darthcloud/BlueRetroHW/README.md

# BlueRetroHW
Kicad for BlueRetro project

BlueRetro

More detail:\
[Main hackaday.io page](https://hackaday.io/project/170365-blueretro)\
[Software files repository](https://github.com/darthcloud/BlueRetro)
