darthcloud/BlueRetroHW/Testjig/testjig.pdf

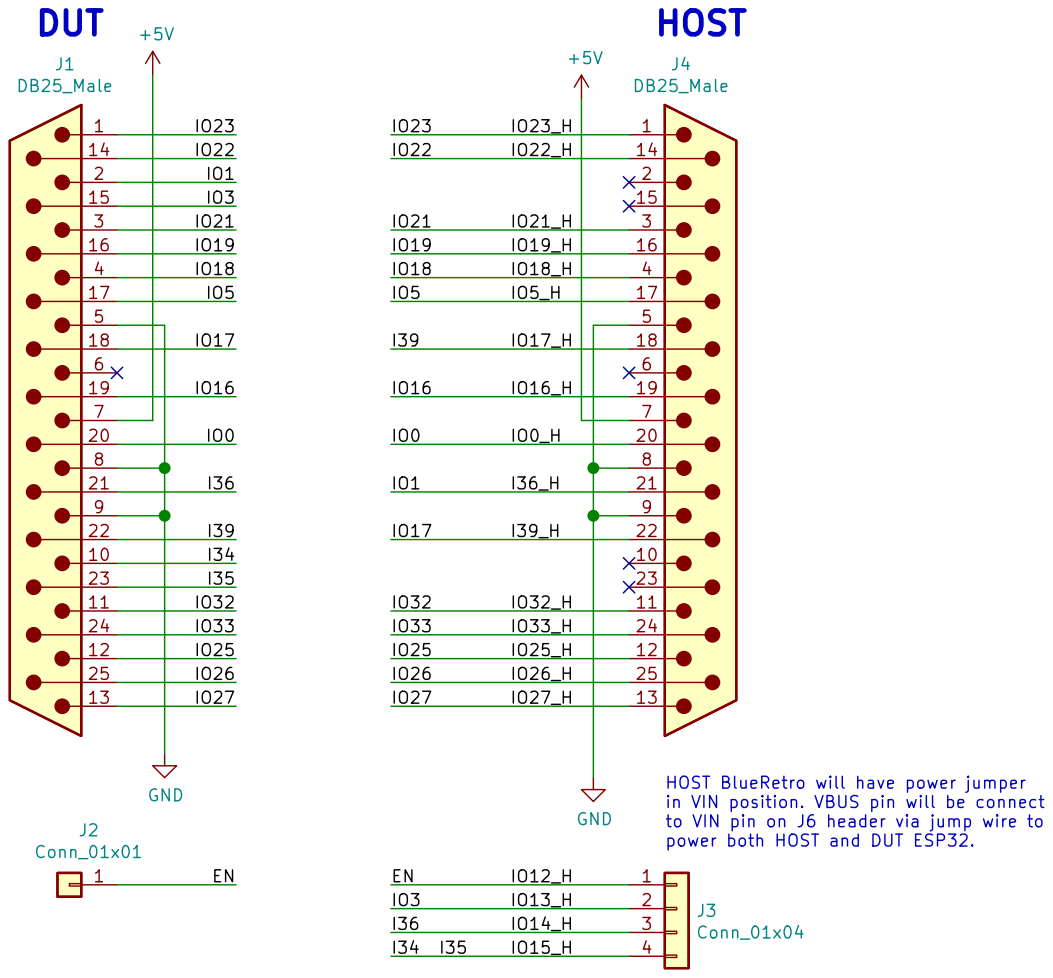
[picture p1: page 1]

HOST BlueRetro will have power jumper
in VIN position. VBUS pin will be connect
to VIN pin on J6 header via jump wire to
power both HOST and DUT ESP32.

File: testjig.sch Sheet: / ©2020 Jacques Gagnon, licensed under CC-BY-4.0

Id: 1/2 Title: BlueRetro Testjig
