darthcloud/BlueRetroHW/Cables/symbol/PinoutReference.pdf

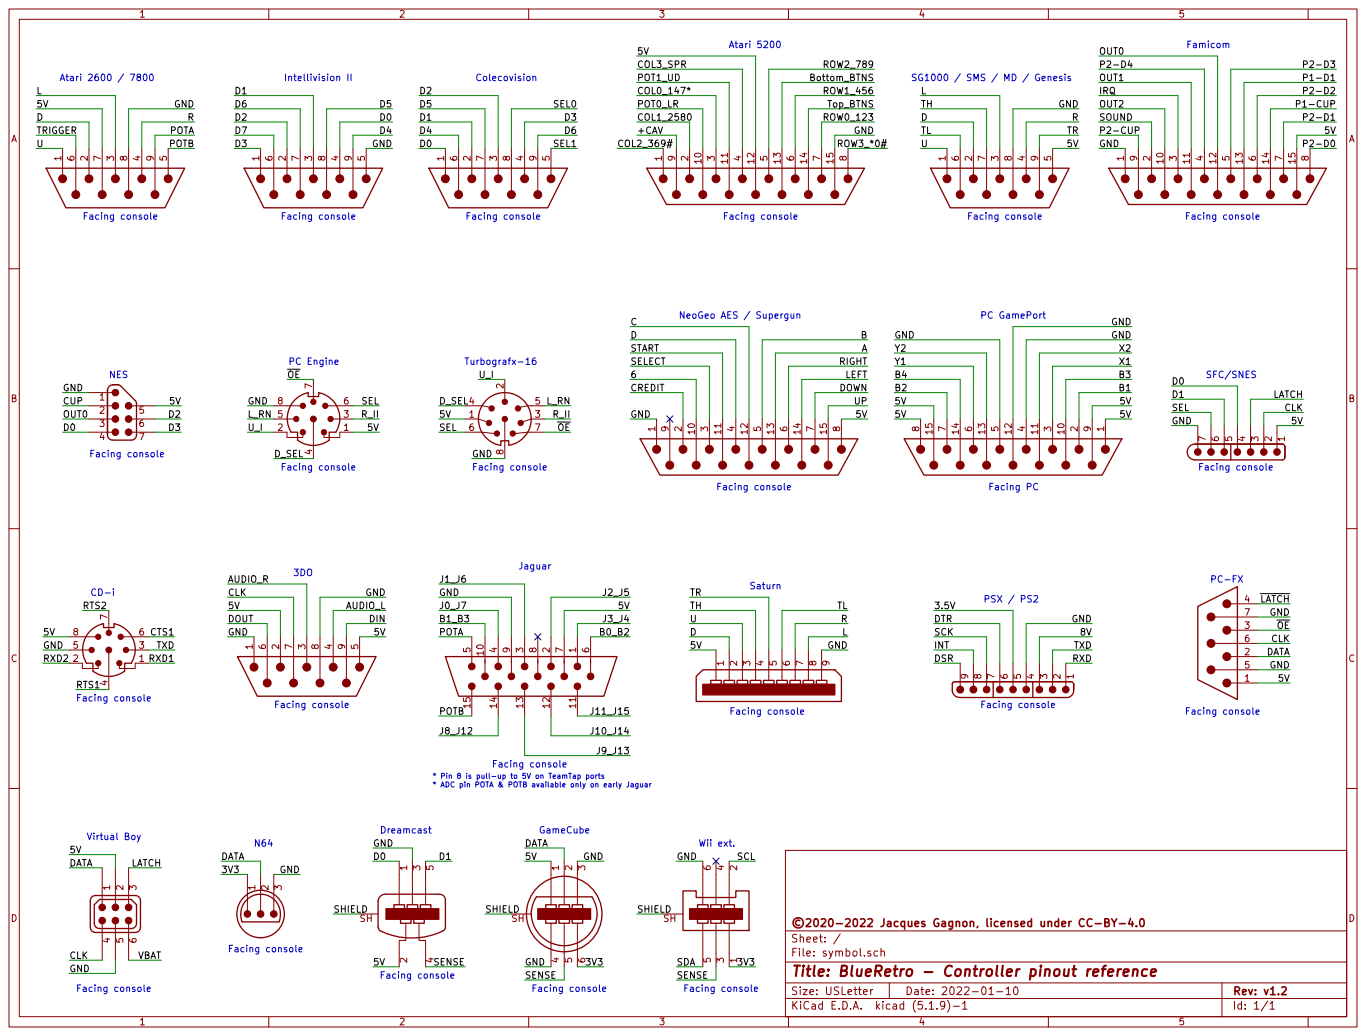
[picture p2: page 1]

LATCHOE DATA CLK GND GND

* Pin 8 is pull-up to 5V on TeamTap ports

File: symbol.sch Sheet: / ©2020-2022 Jacques Gagnon, licensed under CC-BY-4.0

Id: 1/1 Title: BlueRetro - Controller pinout reference
