darthcloud/BlueRetroHW/DIY/AVFC.pdf

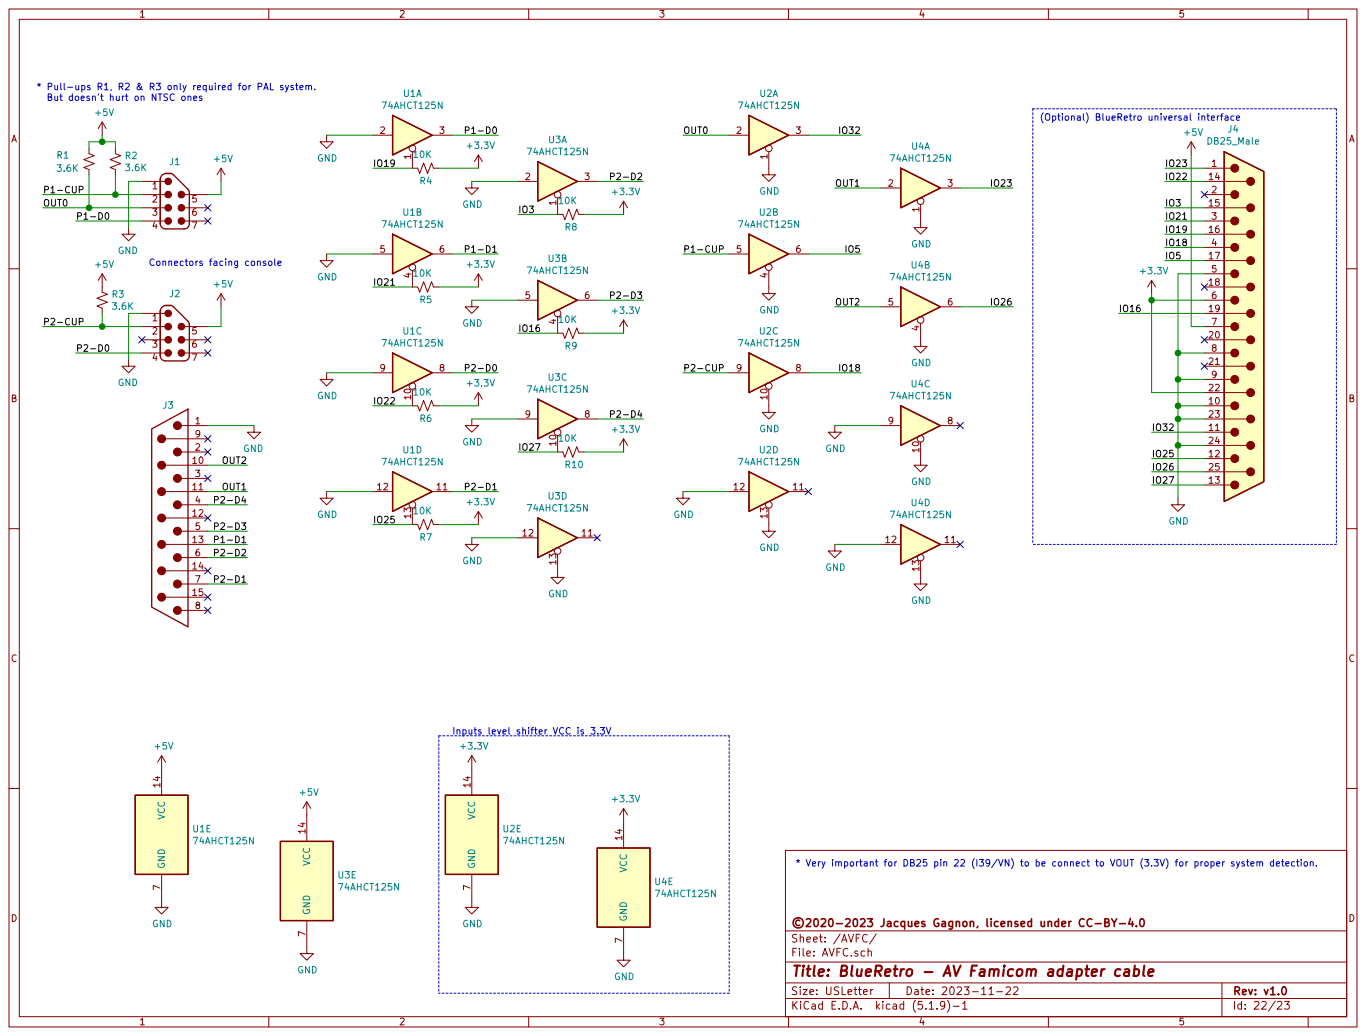
[picture p3: page 1]

* Pull-ups R1, R2 & R3 only required for PAL system.
But doesn't hurt on NTSC ones Connectors facing console

(Optional) BlueRetro universal interface

GND GND GND

Inputs level shifter VCC is 3.3V

File: AVFC.sch Sheet: /AVFC/ ©2020-2023 Jacques Gagnon, licensed under CC-BY-4.0 VCC 14 GND

* Very important for DB25 pin 22 (I39/VN) to be connect to VOUT (3.3V) for proper system detection.

Id: 22/23 Title: BlueRetro - AV Famicom adapter cable
