darthcloud/BlueRetroHW/DIY/FC.pdf

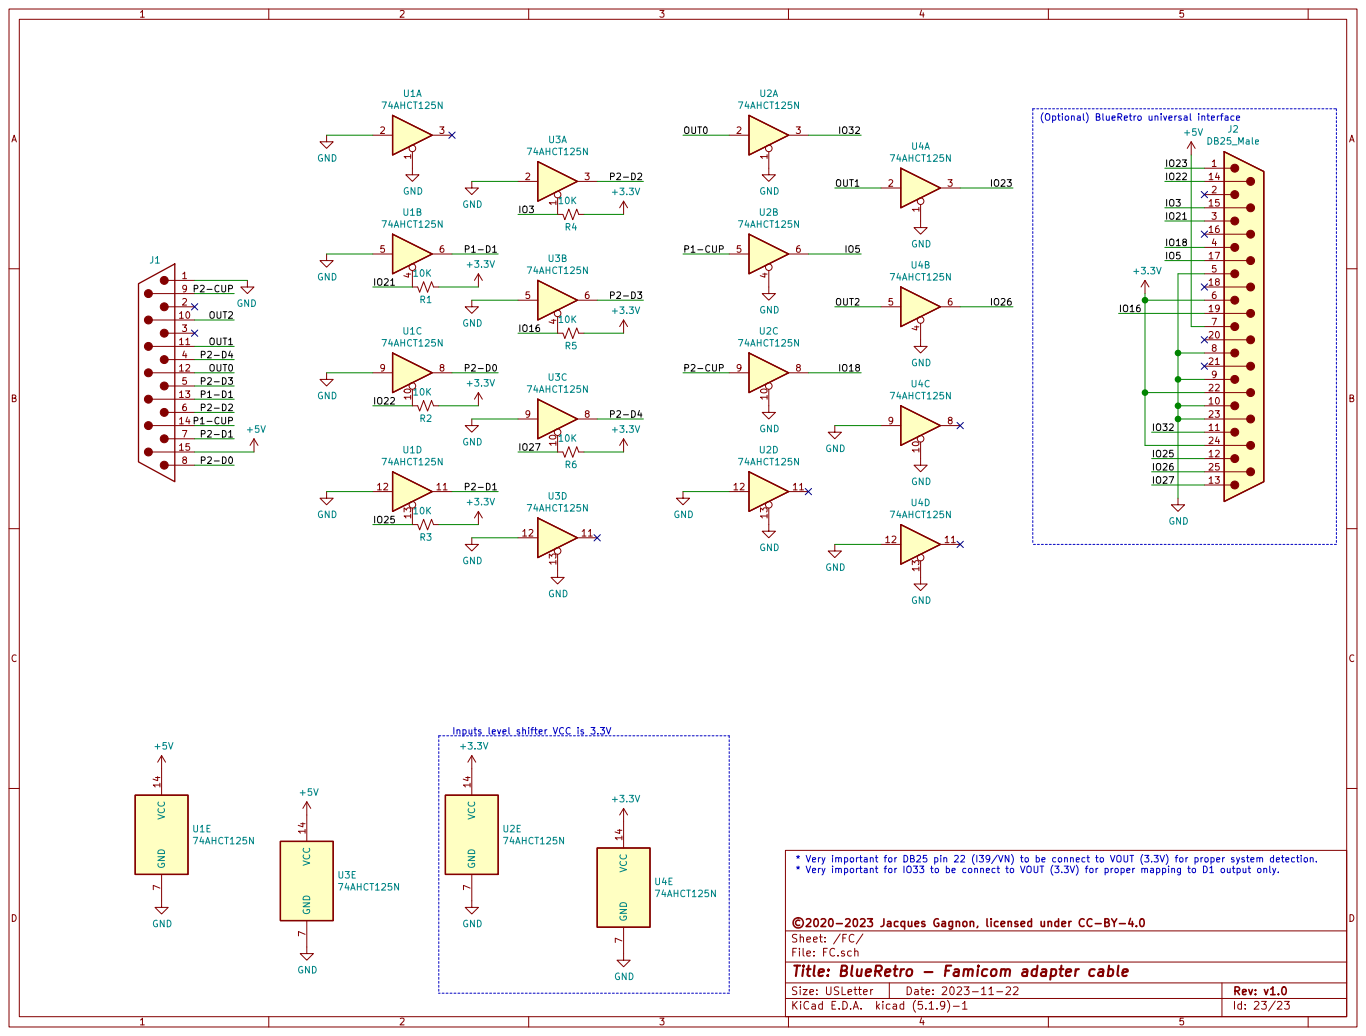
[picture p4: page 1]

GND GND GND GND VCC 14 GND

(Optional) BlueRetro universal interface

74AHCT125N GND GND GND GND

Inputs level shifter VCC is 3.3V

* Very important for DB25 pin 22 (I39/VN) to be connect to VOUT (3.3V) for proper system detection.
* Very important for IO33 to be connect to VOUT (3.3V) for proper mapping to D1 output only.

File: FC.sch Sheet: /FC/ ©2020-2023 Jacques Gagnon, licensed under CC-BY-4.0

Id: 23/23 Title: BlueRetro - Famicom adapter cable
