darthcloud/BlueRetroHW/DIY/NES.pdf

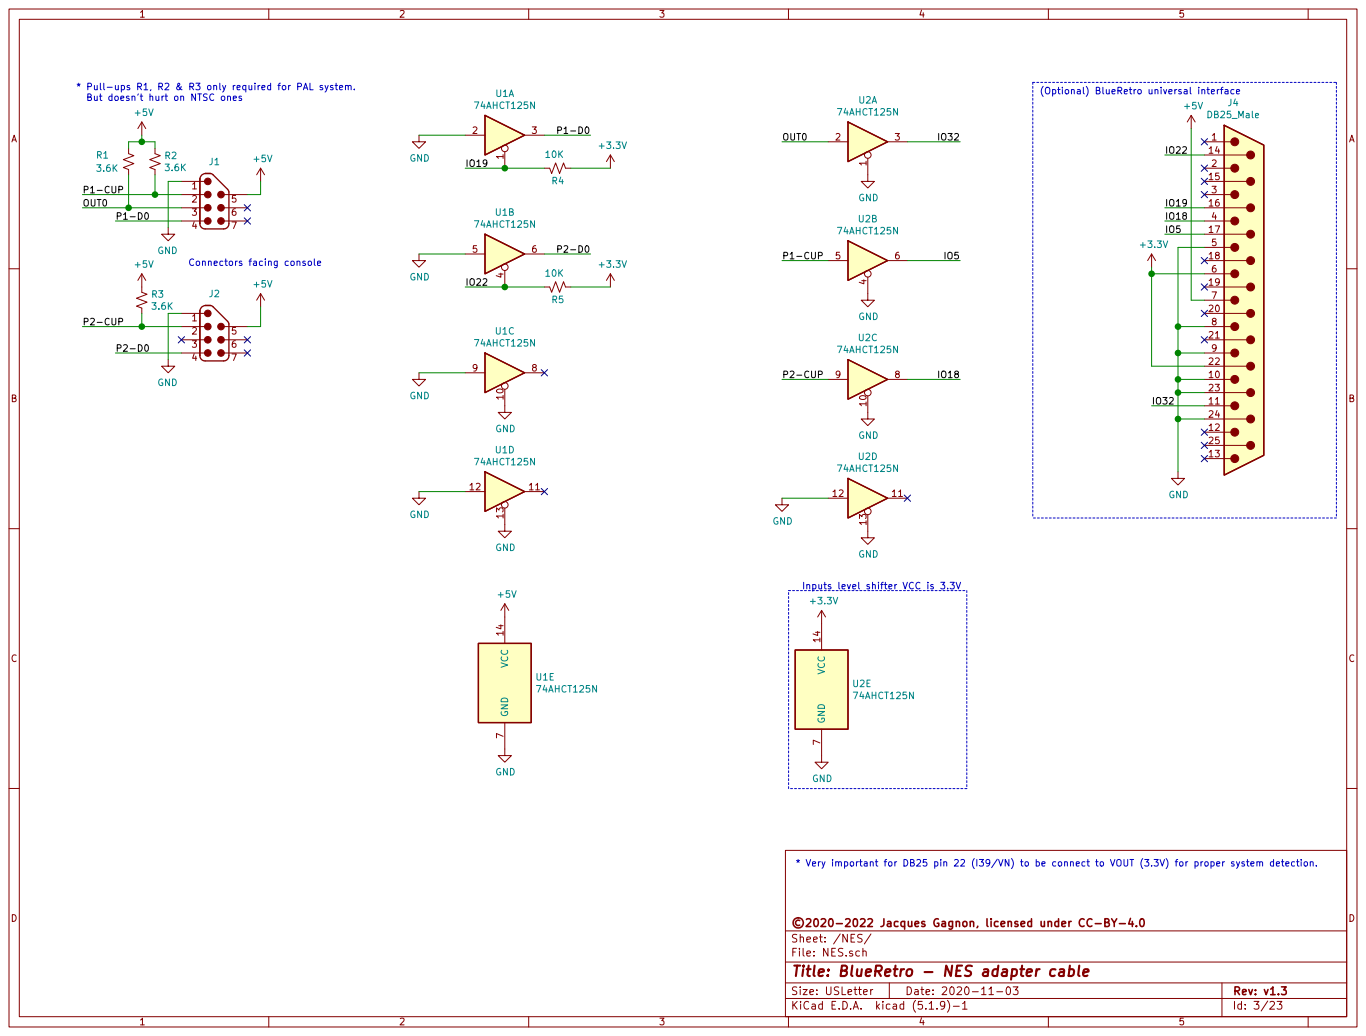
[picture p5: page 1]
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

(Optional) BlueRetro universal interface

Inputs level shifter VCC is 3.3V

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

File: NES.sch Sheet: /NES/ ©2020-2022 Jacques Gagnon, licensed under CC-BY-4.0

Id: 3/23 Title: BlueRetro - NES adapter cable
