darthcloud/BlueRetroHW/DIY/Para1P_OD.pdf

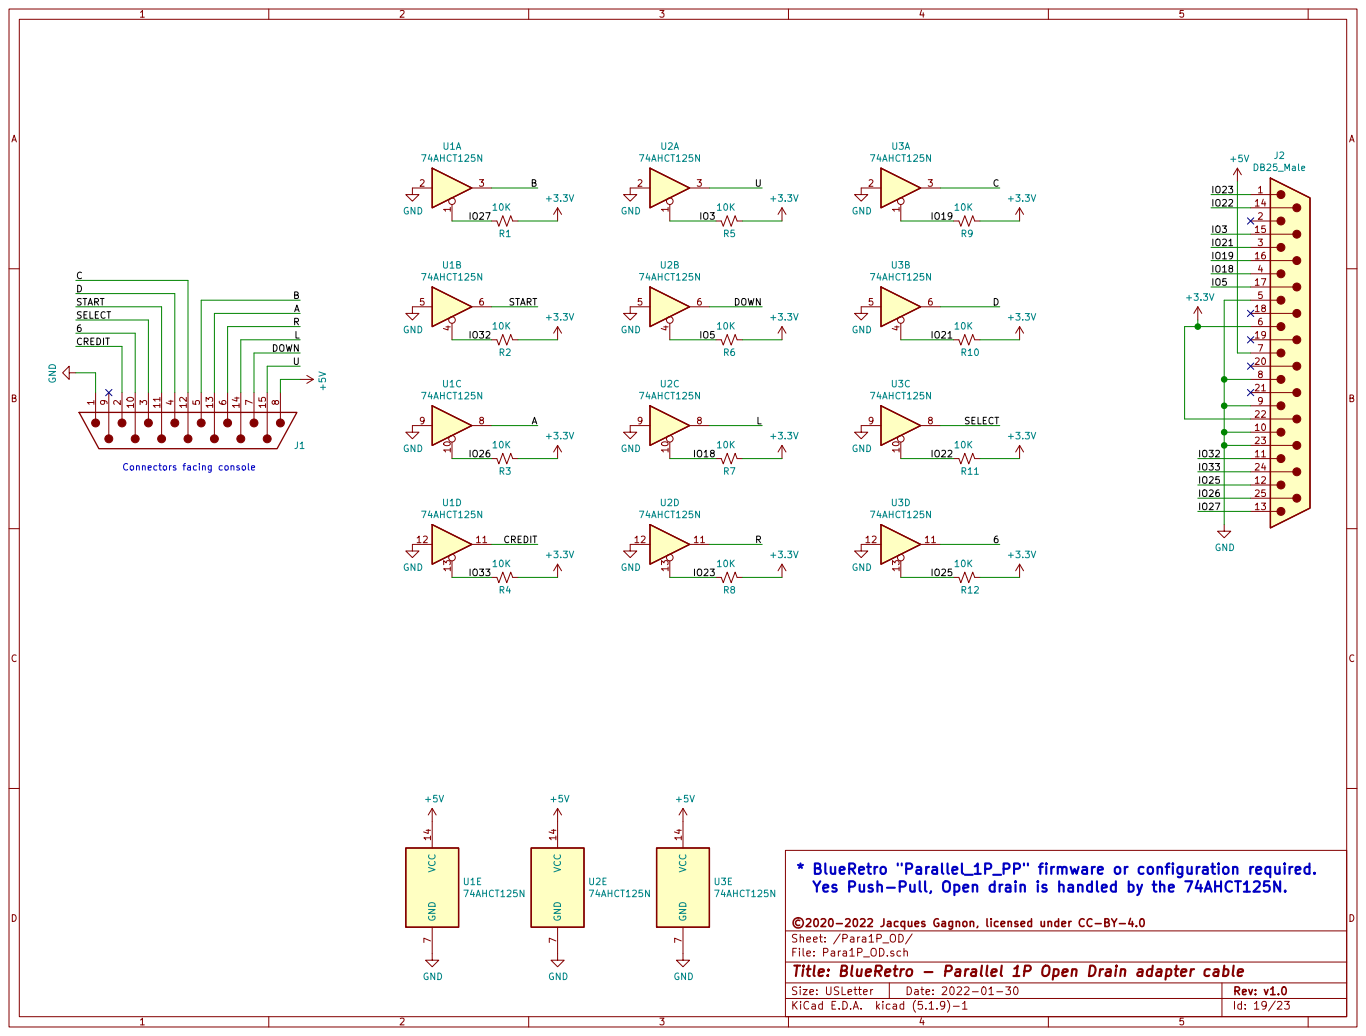
[picture p6: page 1]

* BlueRetro "Parallel_1P_PP" firmware or configuration required.
Yes Push-Pull, Open drain is handled by the 74AHCT125N.

©2020-2022 Jacques Gagnon, licensed under CC-BY-4.0 GND

Sheet: /Para1P_OD/
File: Para1P_OD.sch
Id: 19/23 Title: BlueRetro - Parallel 1P Open Drain adapter cable
