darthcloud/BlueRetroHW/DIY/Para2P_OD.pdf

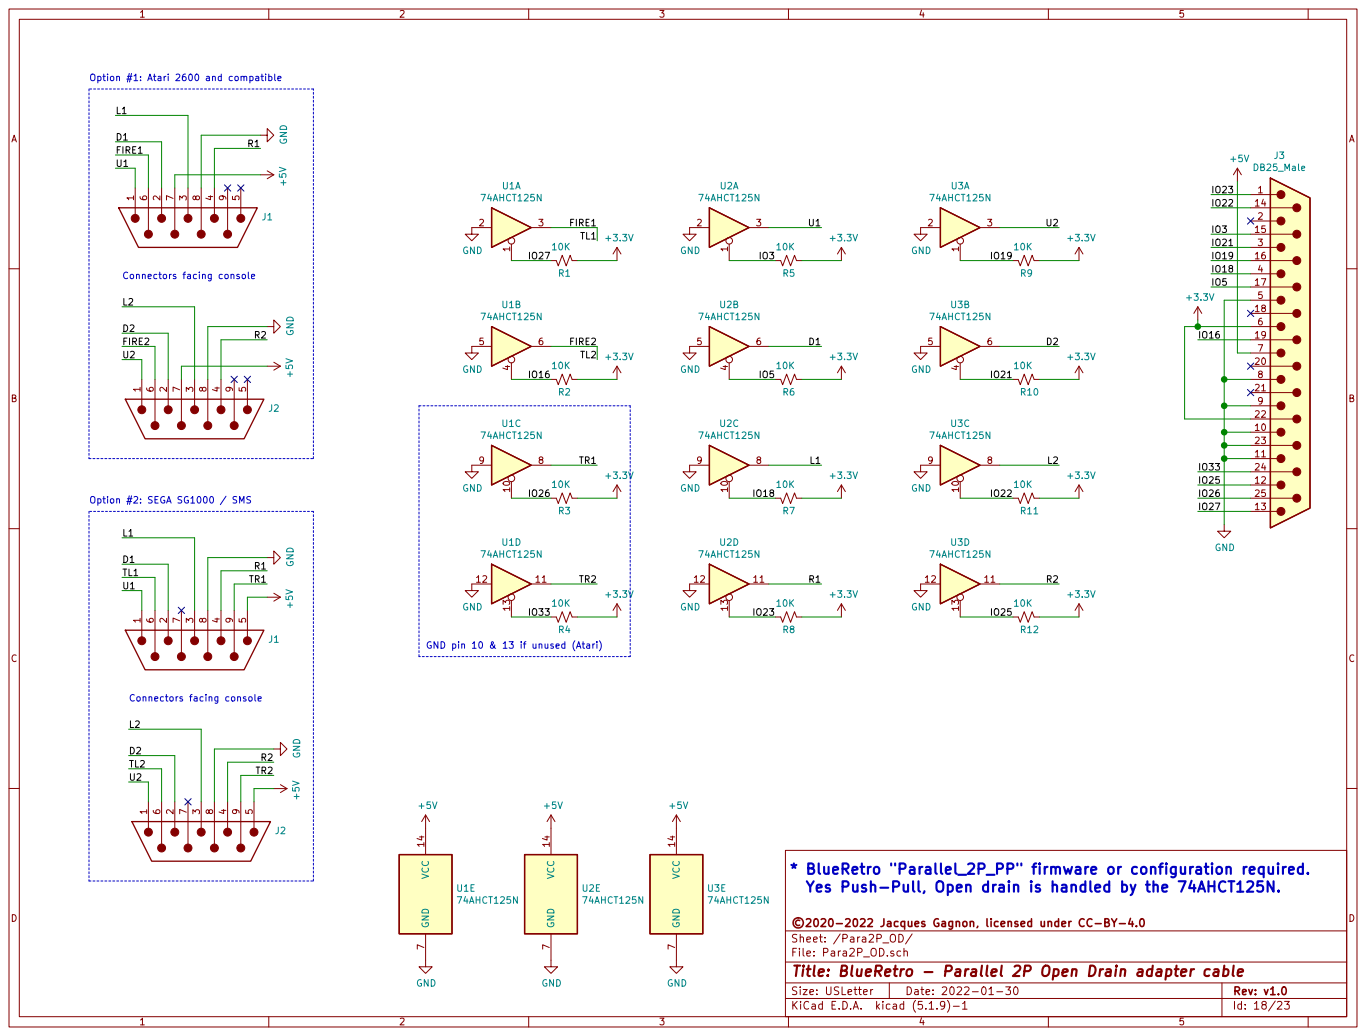
[picture p7: page 1]

Option #1: Atari 2600 and compatible

74AHCT125N GND GND GND GND

GND pin 10 & 13 if unused (Atari)

* BlueRetro "Parallel_2P_PP" firmware or configuration required.
Yes Push-Pull, Open drain is handled by the 74AHCT125N.

©2020-2022 Jacques Gagnon, licensed under CC-BY-4.0
Sheet: /Para2P_OD/
File: Para2P_OD.sch
Id: 18/23 Title: BlueRetro - Parallel 2P Open Drain adapter cable
