darthcloud/BlueRetroHW/DIY/PS.pdf

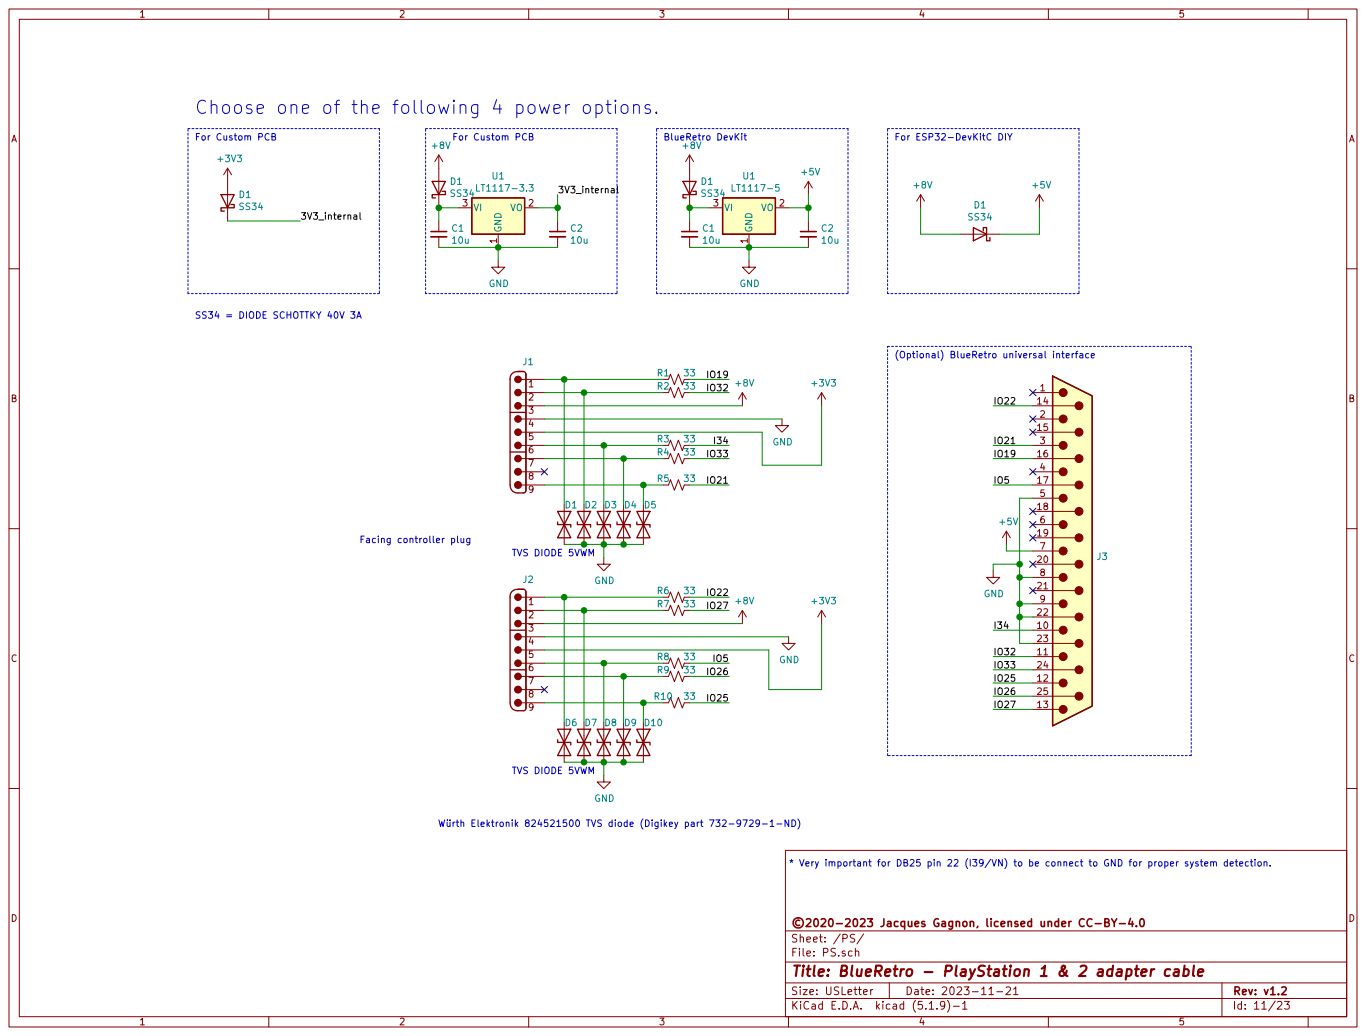
[picture p8: page 1]

IO26 TVS DIODE 5VWM Choose one of the following 4 power options. SS34 = DIODE SCHOTTKY 40V 3A

TVS DIODE 5VWM Facing controller plug

Würth Elektronik 824521500 TVS diode (Digikey part 732-9729-1-ND)

* Very important for DB25 pin 22 (I39/VN) to be connect to GND for proper system detection.

File: PS.sch Sheet: /PS/ ©2020-2023 Jacques Gagnon, licensed under CC-BY-4.0

Id: 11/23 Title: BlueRetro - PlayStation 1 & 2 adapter cable
