darthcloud/BlueRetroHW/DIY/Wii.pdf

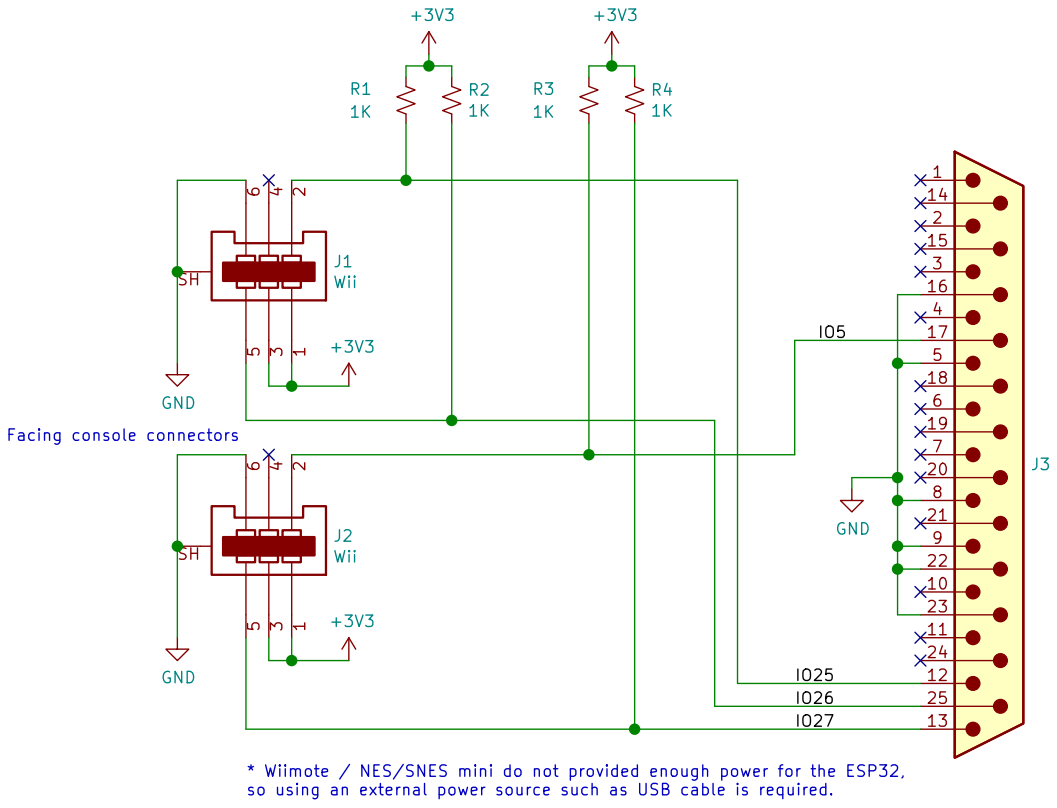
[picture p9: page 1]

* Wiimote / NES/SNES mini do not provided enough power for the ESP32,
so using an external power source such as USB cable is required.

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

File: Wii.sch Sheet: /Wii/ ©2020-2022 Jacques Gagnon, licensed under CC-BY-4.0

Id: 21/21 Title: BlueRetro - Wii extension adapter cable
