darthcloud/BlueRetroHW/DIY/N64.pdf

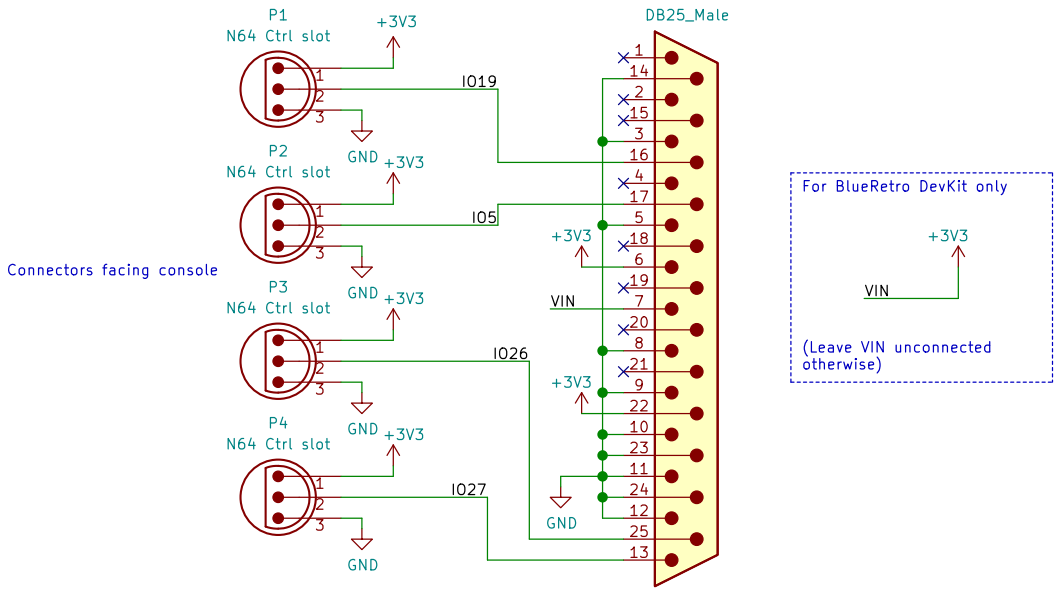
[picture p10: page 1]

For BlueRetro DevKit only

* Very important for DB25 pin 22 (I39/VN) to be connect to VIN (3.3V) for proper system detection.

File: N64.sch Sheet: /N64/ ©2020-2022 Jacques Gagnon, licensed under CC-BY-4.0

Id: 5/20 Title: BlueRetro - N64 adapter cable
