darthcloud/BlueRetroHW/DIY/VB.pdf

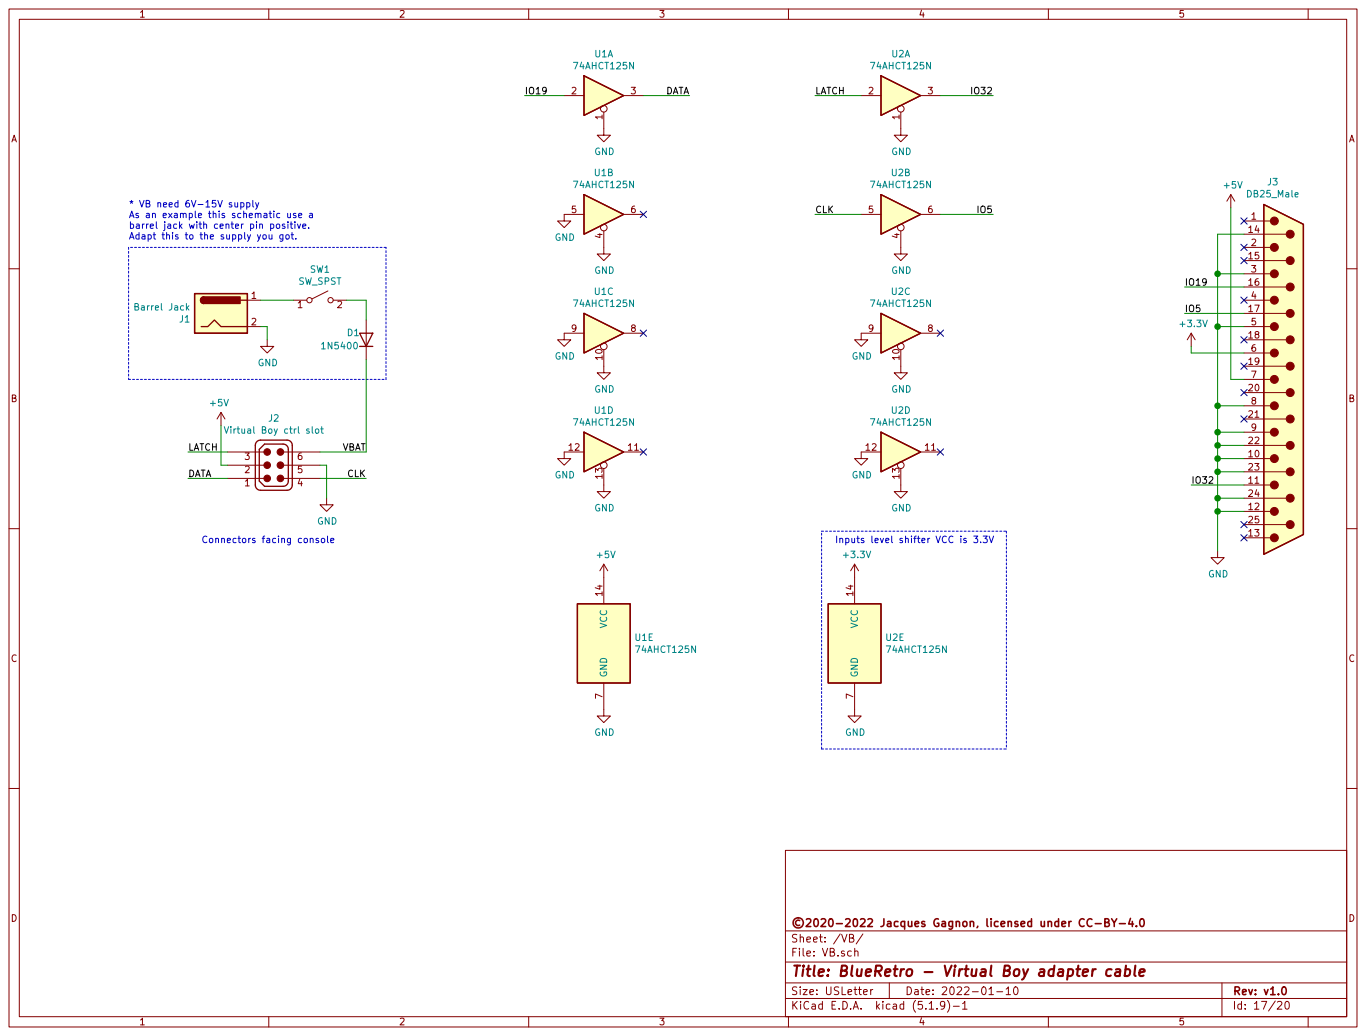
[picture p11: page 1]

* VB need 6V-15V supply
As an example this schematic use a
barrel jack with center pin positive.
Adapt this to the supply you got.

File: VB.sch Sheet: /VB/ ©2020-2022 Jacques Gagnon, licensed under CC-BY-4.0

Id: 17/20 Title: BlueRetro - Virtual Boy adapter cable
