darthcloud/BlueRetroHW/DIY/Saturn.pdf

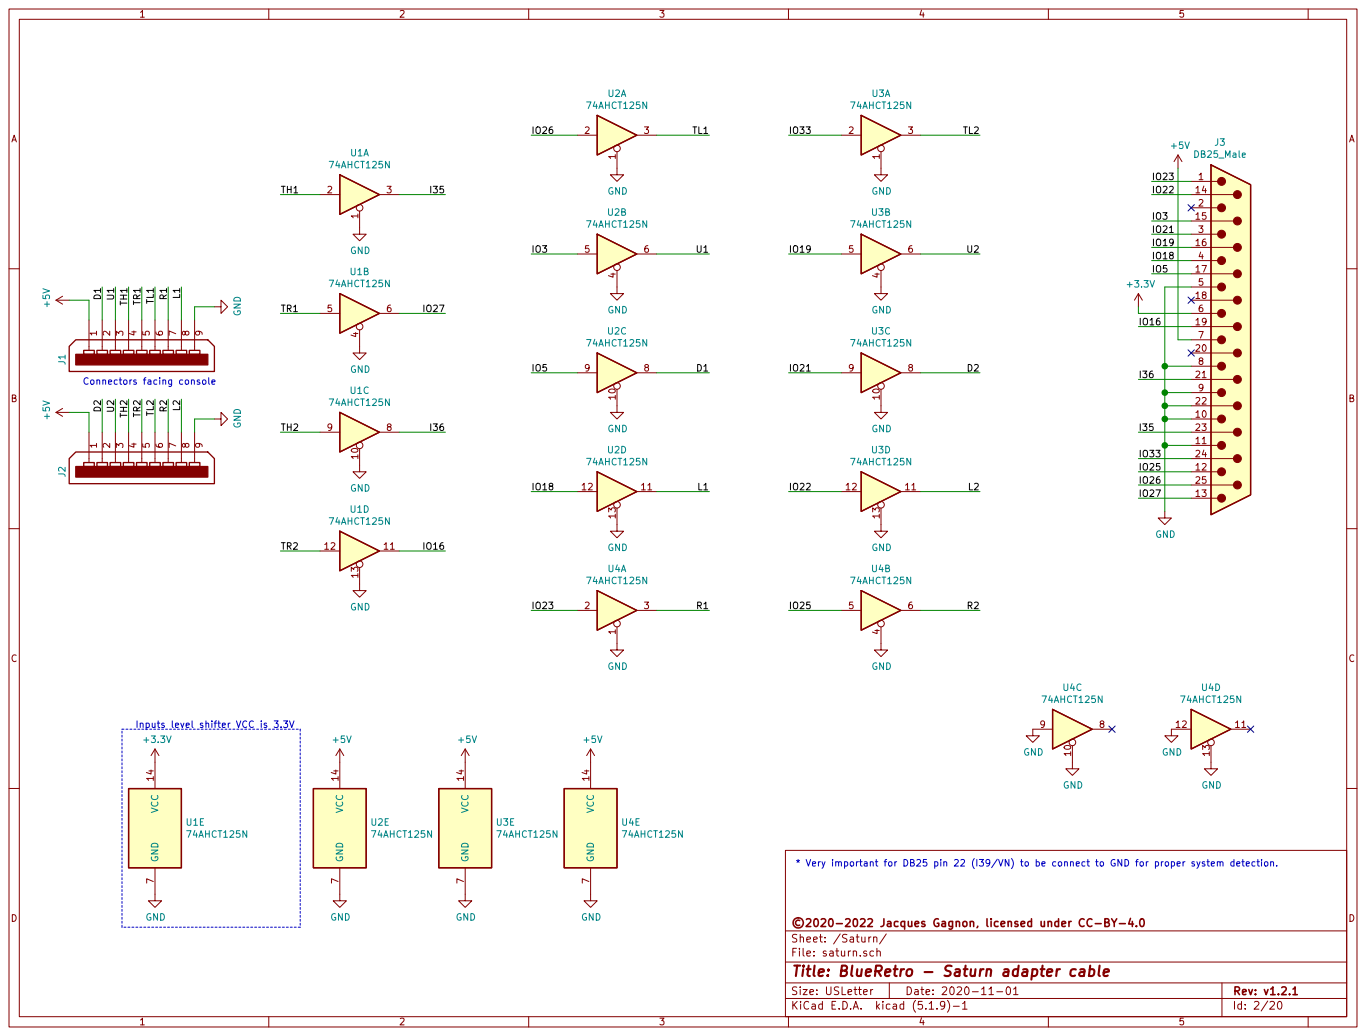
[picture p12: page 1]

Inputs level shifter VCC is 3.3V

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

File: saturn.sch Sheet: /Saturn/ ©2020-2022 Jacques Gagnon, licensed under CC-BY-4.0

Id: 2/20 Title: BlueRetro - Saturn adapter cable
