darthcloud/BlueRetroHW/DIY/PCE.pdf

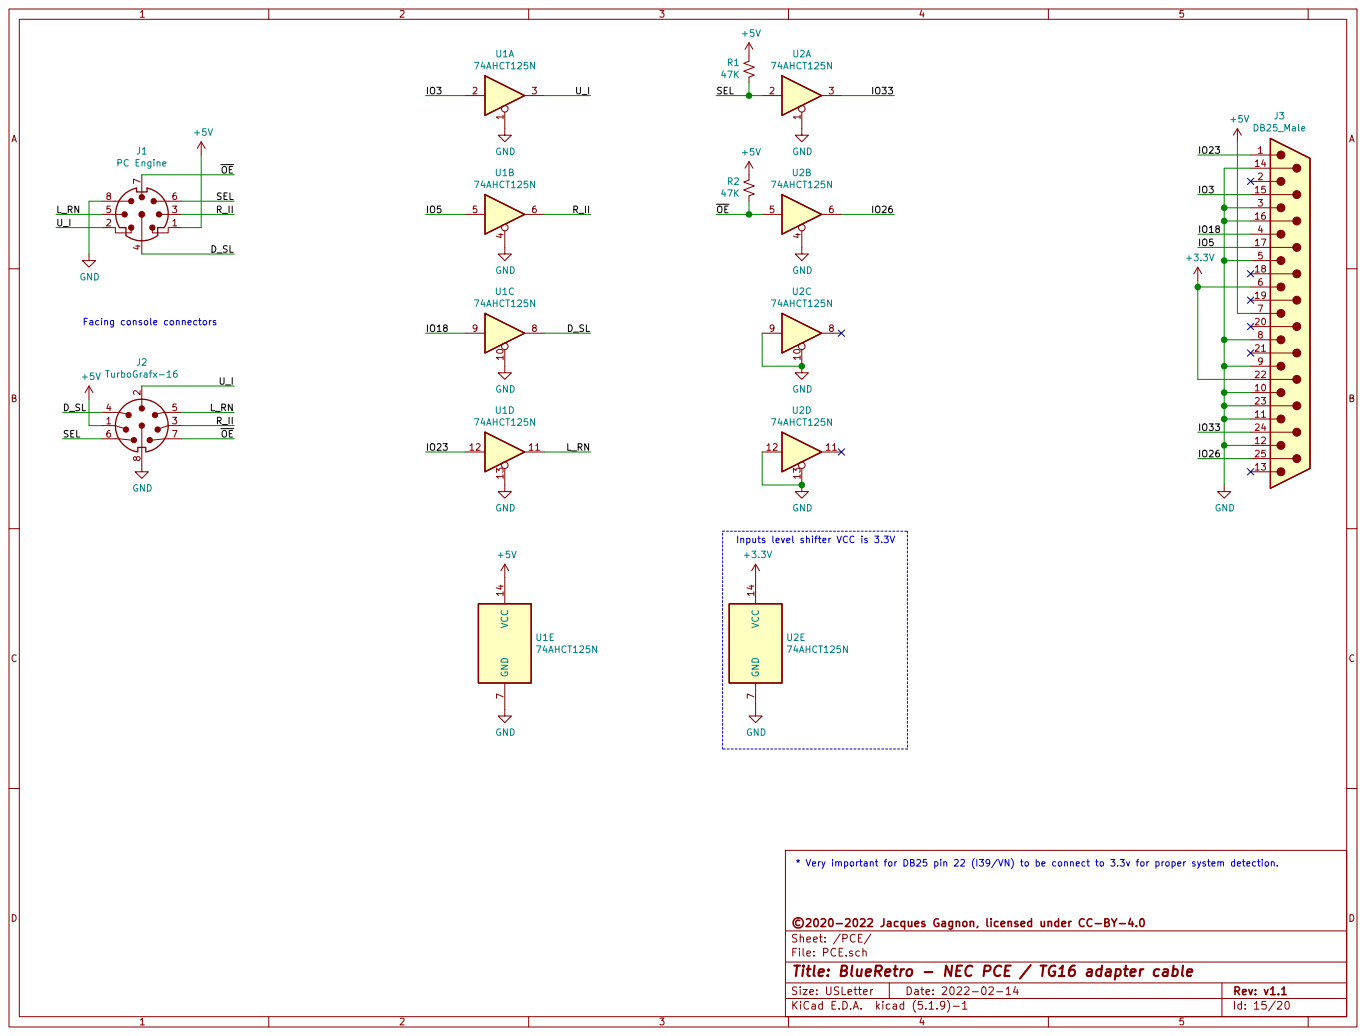
[picture p13: page 1]

Inputs level shifter VCC is 3.3V

* Very important for DB25 pin 22 (I39/VN) to be connect to 3.3v for proper system detection.

File: PCE.sch Sheet: /PCE/ ©2020-2022 Jacques Gagnon, licensed under CC-BY-4.0

Id: 15/20 Title: BlueRetro - NEC PCE / TG16 adapter cable
