darthcloud/BlueRetroHW/DIY/7800.pdf

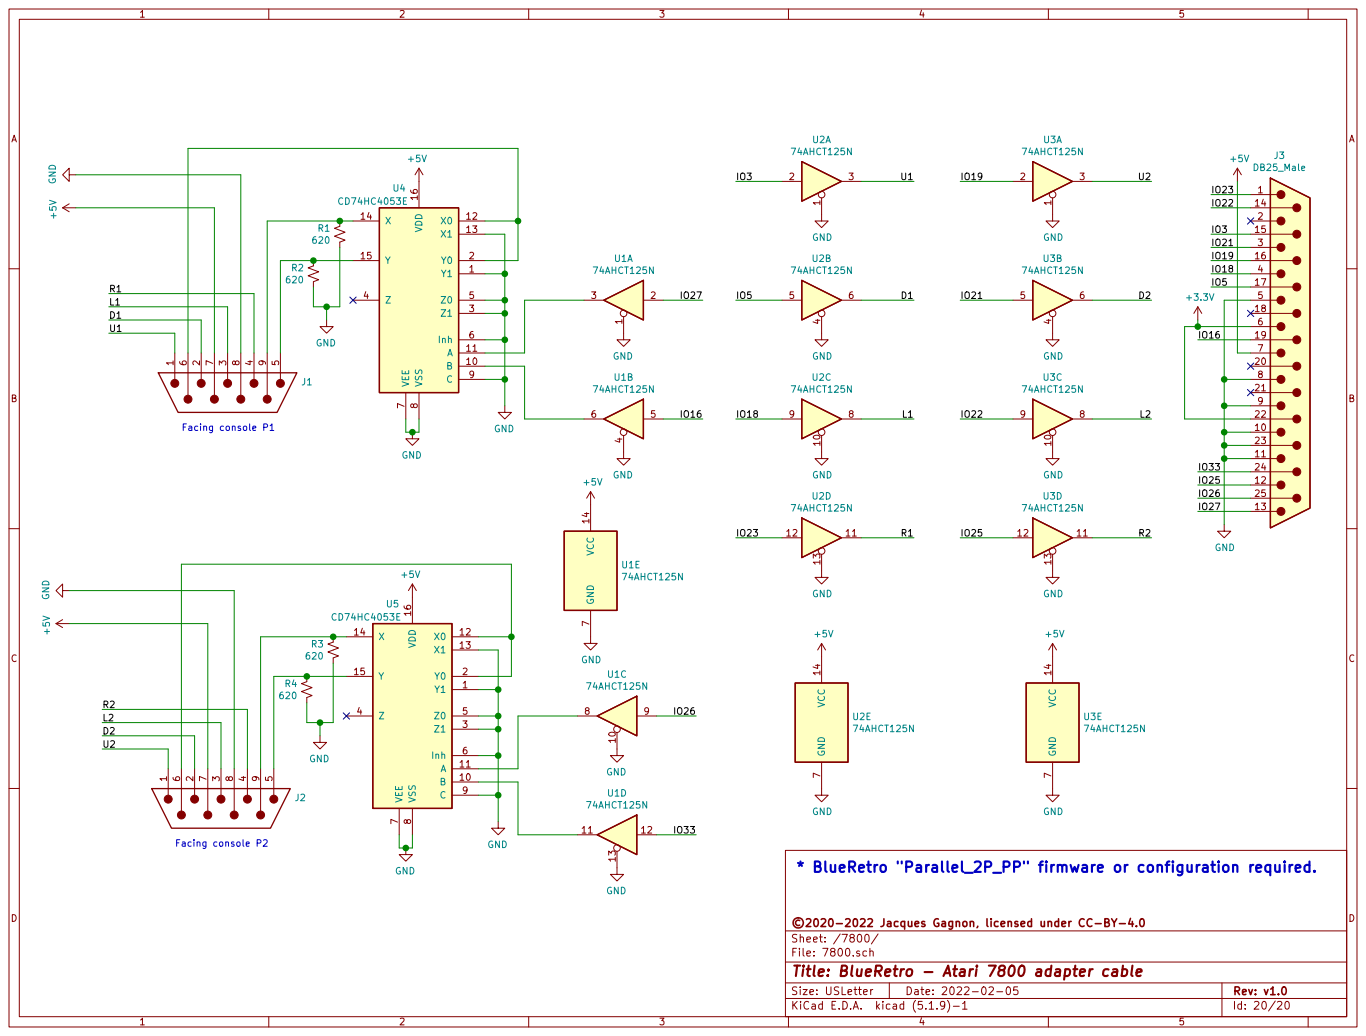
[picture p14: page 1]

File: 7800.sch Sheet: /7800/ ©2020-2022 Jacques Gagnon, licensed under CC-BY-4.0 GND

* BlueRetro "Parallel_2P_PP" firmware or configuration required.

Id: 20/20 Title: BlueRetro - Atari 7800 adapter cable
