darthcloud/BlueRetroHW/DIY/Para1P_PP.pdf

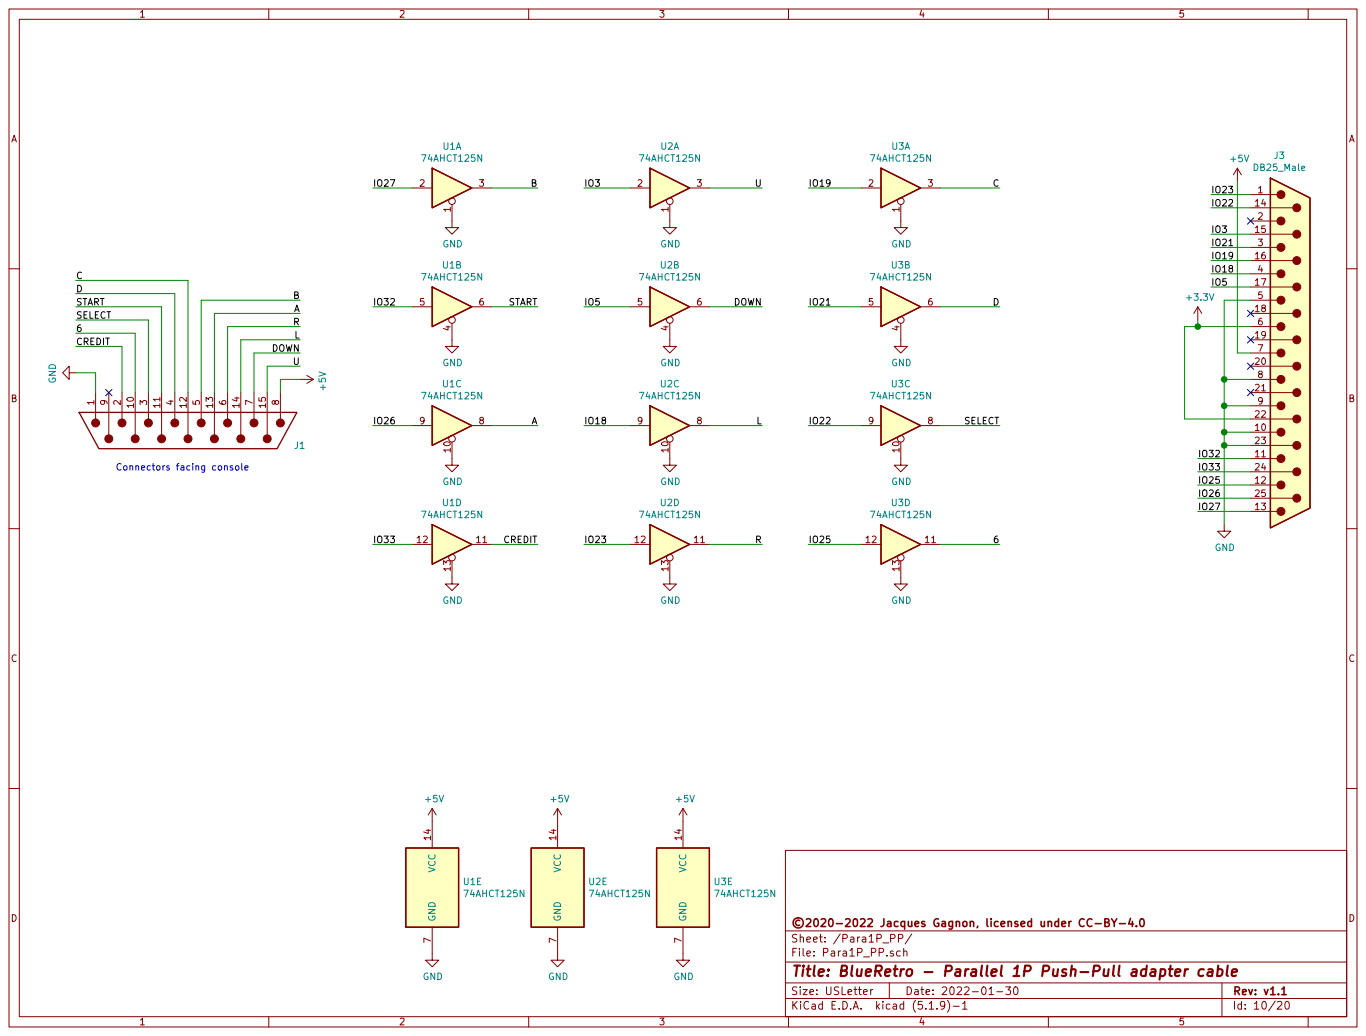
[picture p15: page 1]

74AHCT125N
+5V GND GND GND GND

©2020-2022 Jacques Gagnon, licensed under CC-BY-4.0
Sheet: /Para1P_PP/
File: Para1P_PP.sch
Id: 10/20 Title: BlueRetro - Parallel 1P Push-Pull adapter cable
