darthcloud/BlueRetroHW/DIY/Para2P_PP.pdf

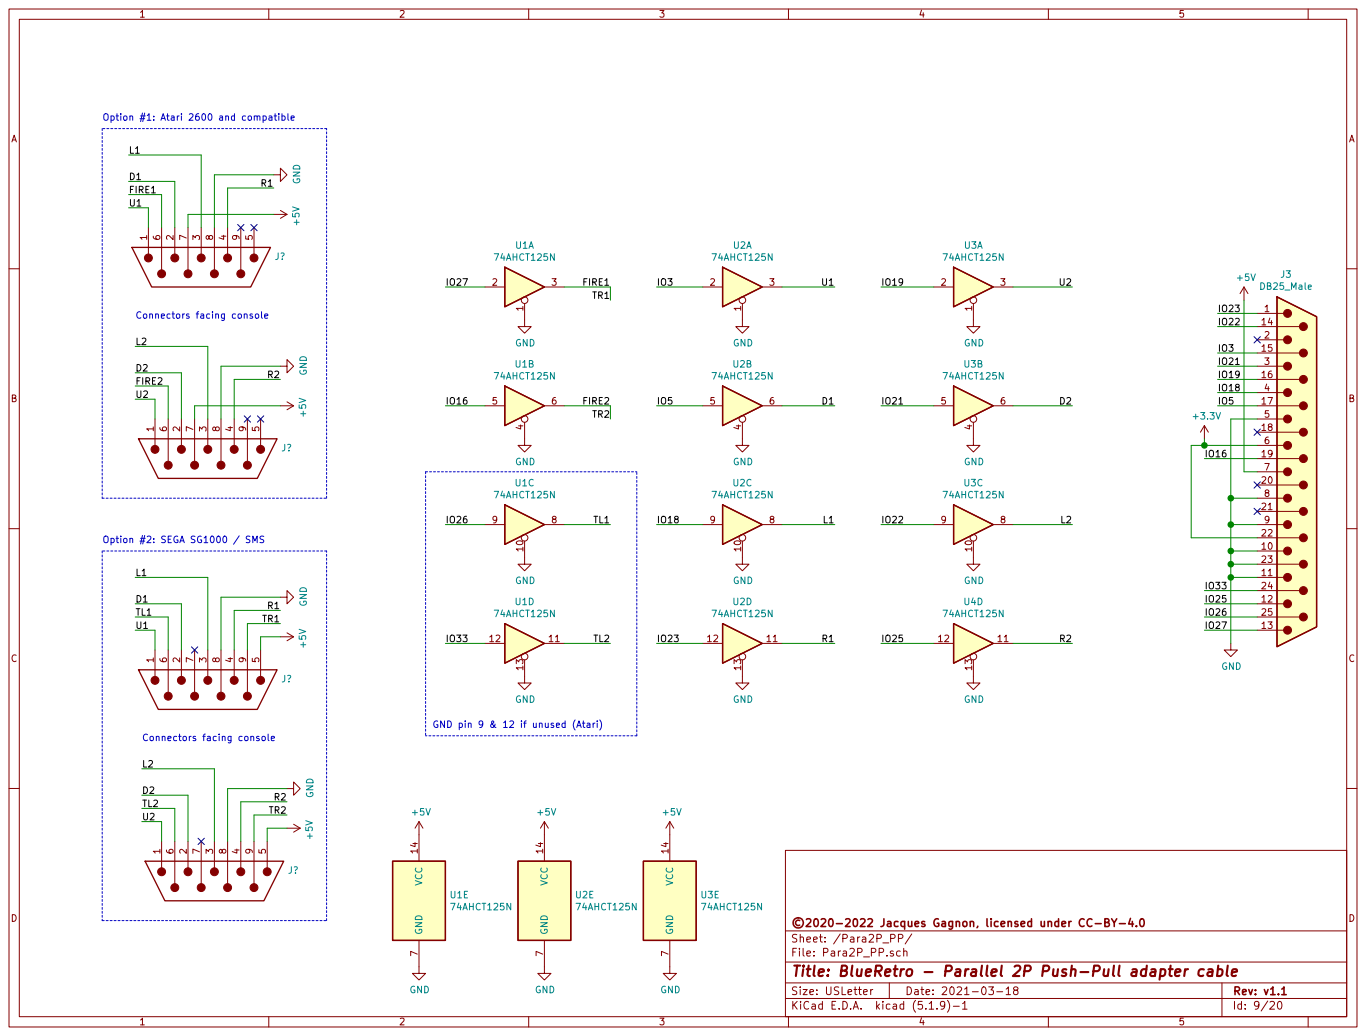
[picture p16: page 1]

Option #1: Atari 2600 and compatible

Sheet: /Para2P_PP/
File: Para2P_PP.sch
Id: 9/20 Title: BlueRetro - Parallel 2P Push-Pull adapter cable
