darthcloud/BlueRetroHW/DIY/JAG.pdf

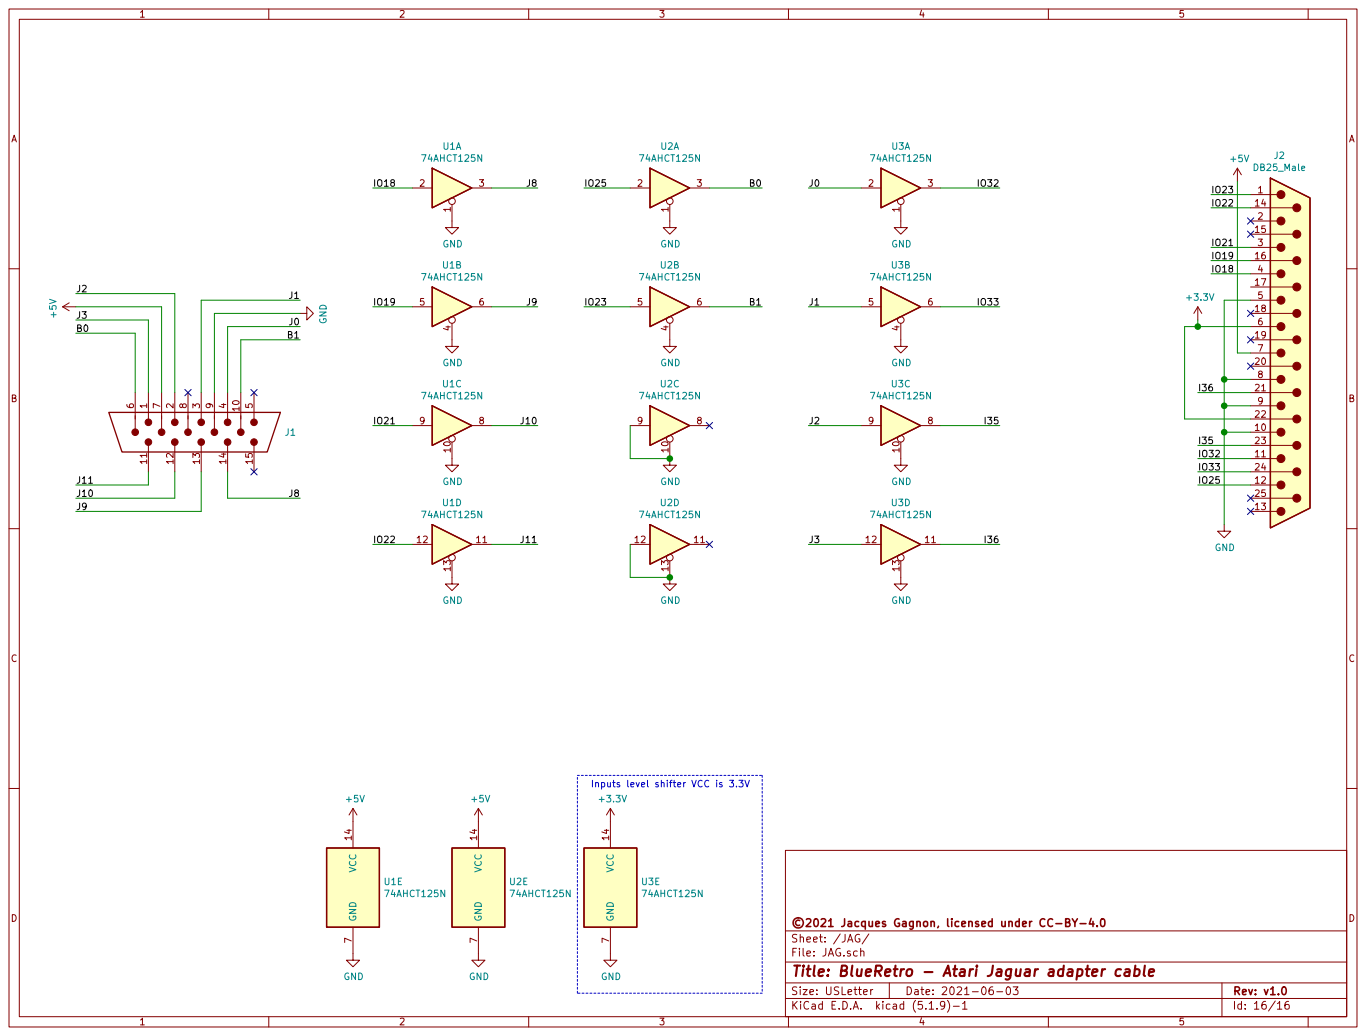
[picture p17: page 1]

Inputs level shifter VCC is 3.3V
+3.3V GNDVCC 14 GND

File: JAG.sch Sheet: /JAG/ ©2021 Jacques Gagnon, licensed under CC-BY-4.0

Id: 16/16 Title: BlueRetro - Atari Jaguar adapter cable
