darthcloud/BlueRetroHW/DIY/3DO.pdf

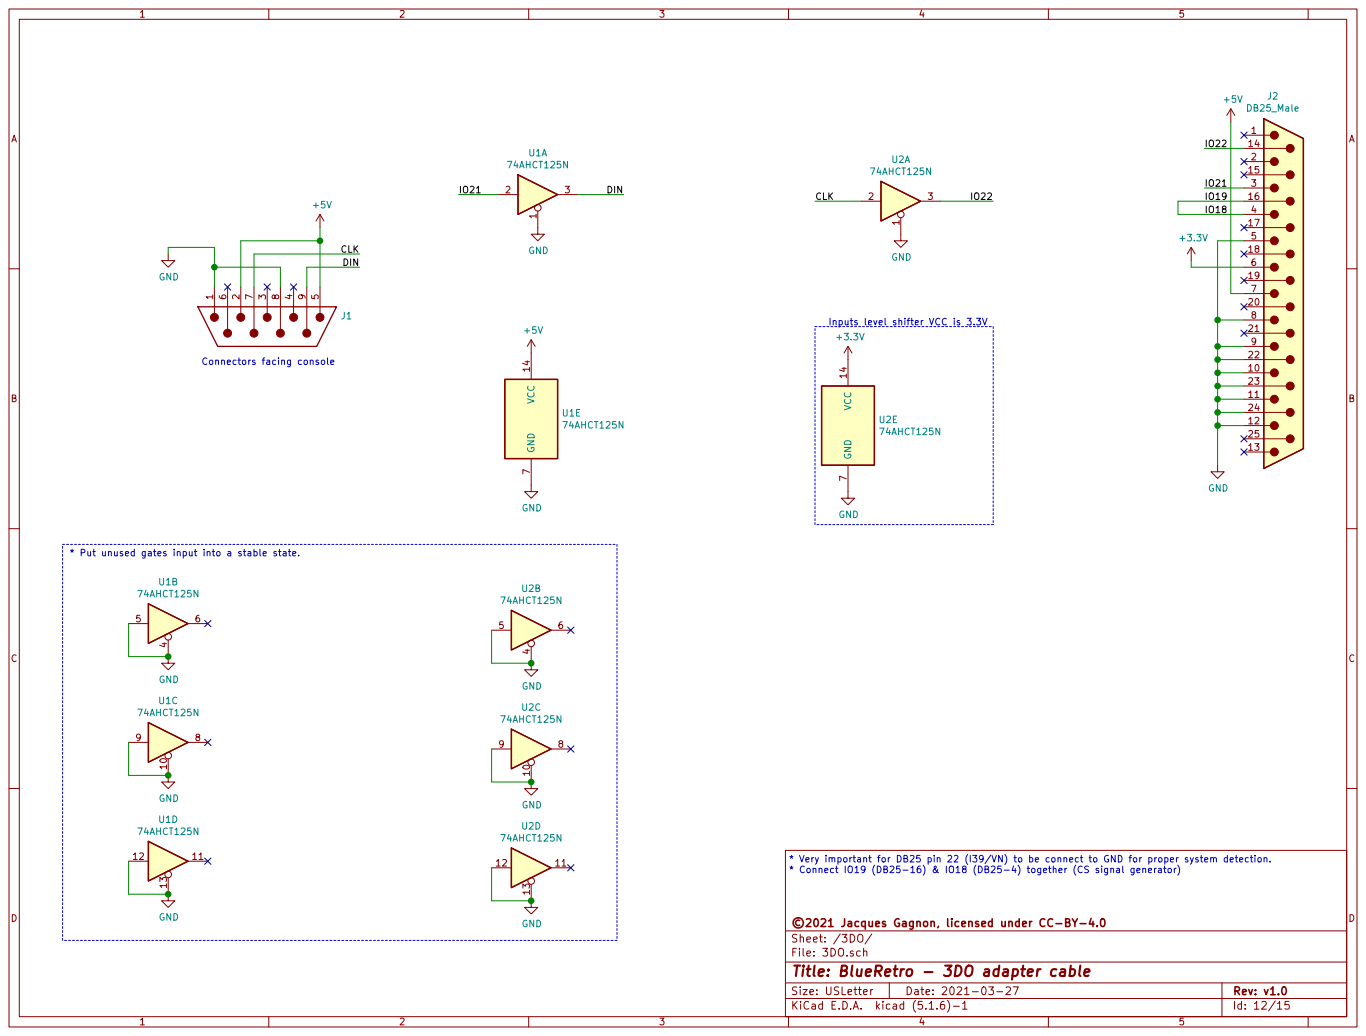
[picture p18: page 1]

Inputs level shifter VCC is 3.3V

* Put unused gates input into a stable state.
74AHCT125N 10

File: 3DO.sch Sheet: /3DO/ ©2021 Jacques Gagnon, licensed under CC-BY-4.0 10

* Very important for DB25 pin 22 (I39/VN) to be connect to GND for proper system detection.
* Connect IO19 (DB25-16) & IO18 (DB25-4) together (CS signal generator)

Id: 12/15 Title: BlueRetro - 3DO adapter cable
