darthcloud/BlueRetroHW/DIY/CDI.pdf

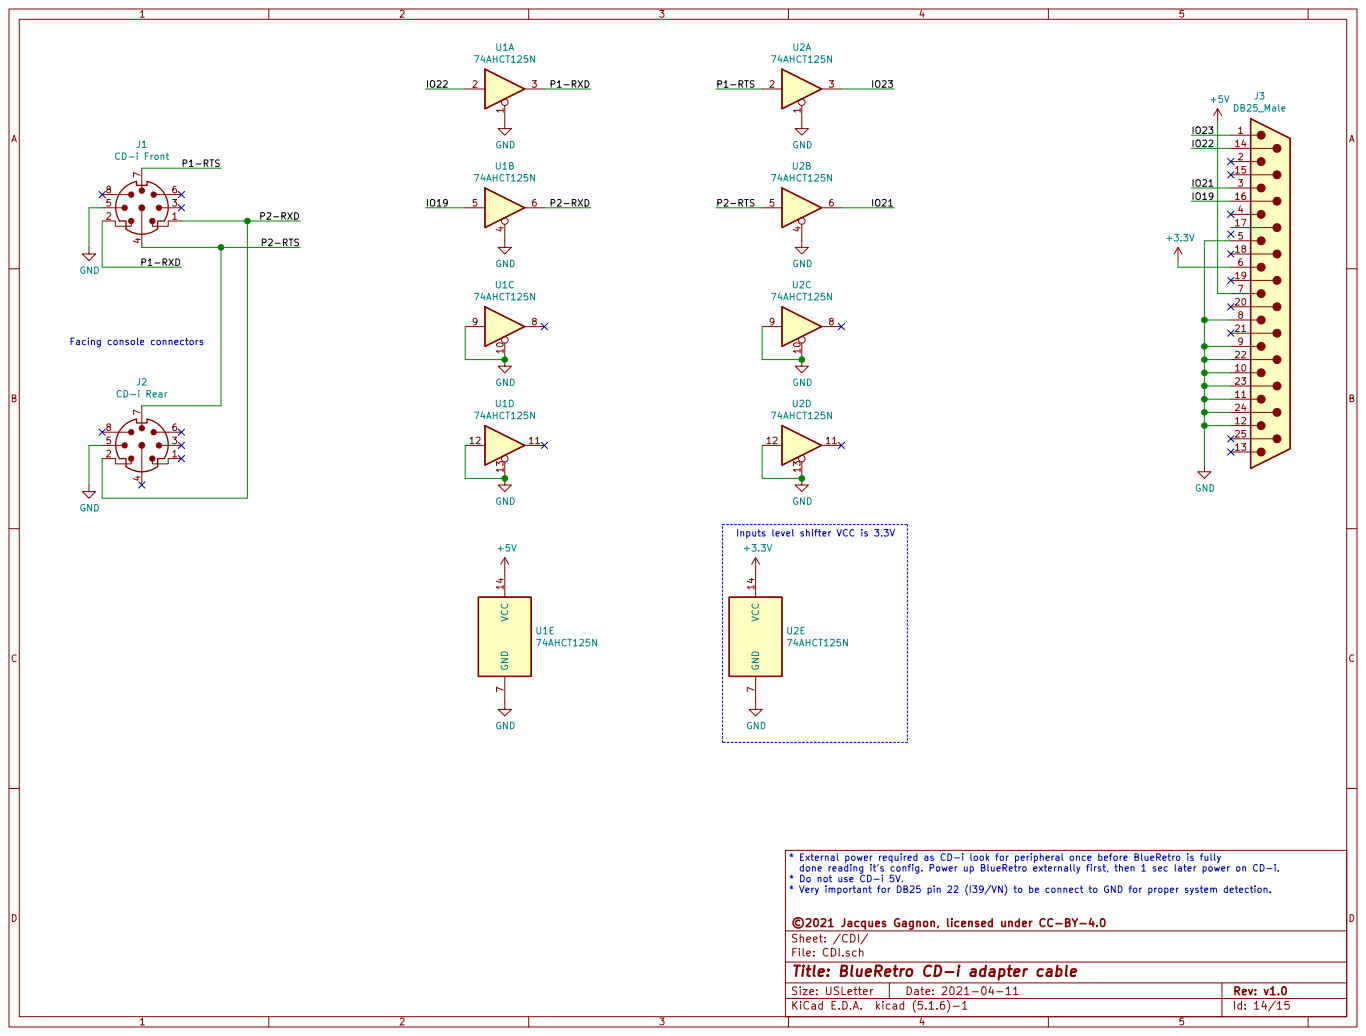
[picture p19: page 1]

Inputs level shifter VCC is 3.3V

* External power required as CD-i look for peripheral once before BlueRetro is fully
done reading it's config. Power up BlueRetro externally first, then 1 sec later power on CD-i. * Do not use CD-i 5V. * Very important for DB25 pin 22 (I39/VN) to be connect to GND for proper system detection.

Id: 14/15 Title: BlueRetro CD-i adapter cable
