darthcloud/BlueRetroHW/DIY/PCFX.pdf

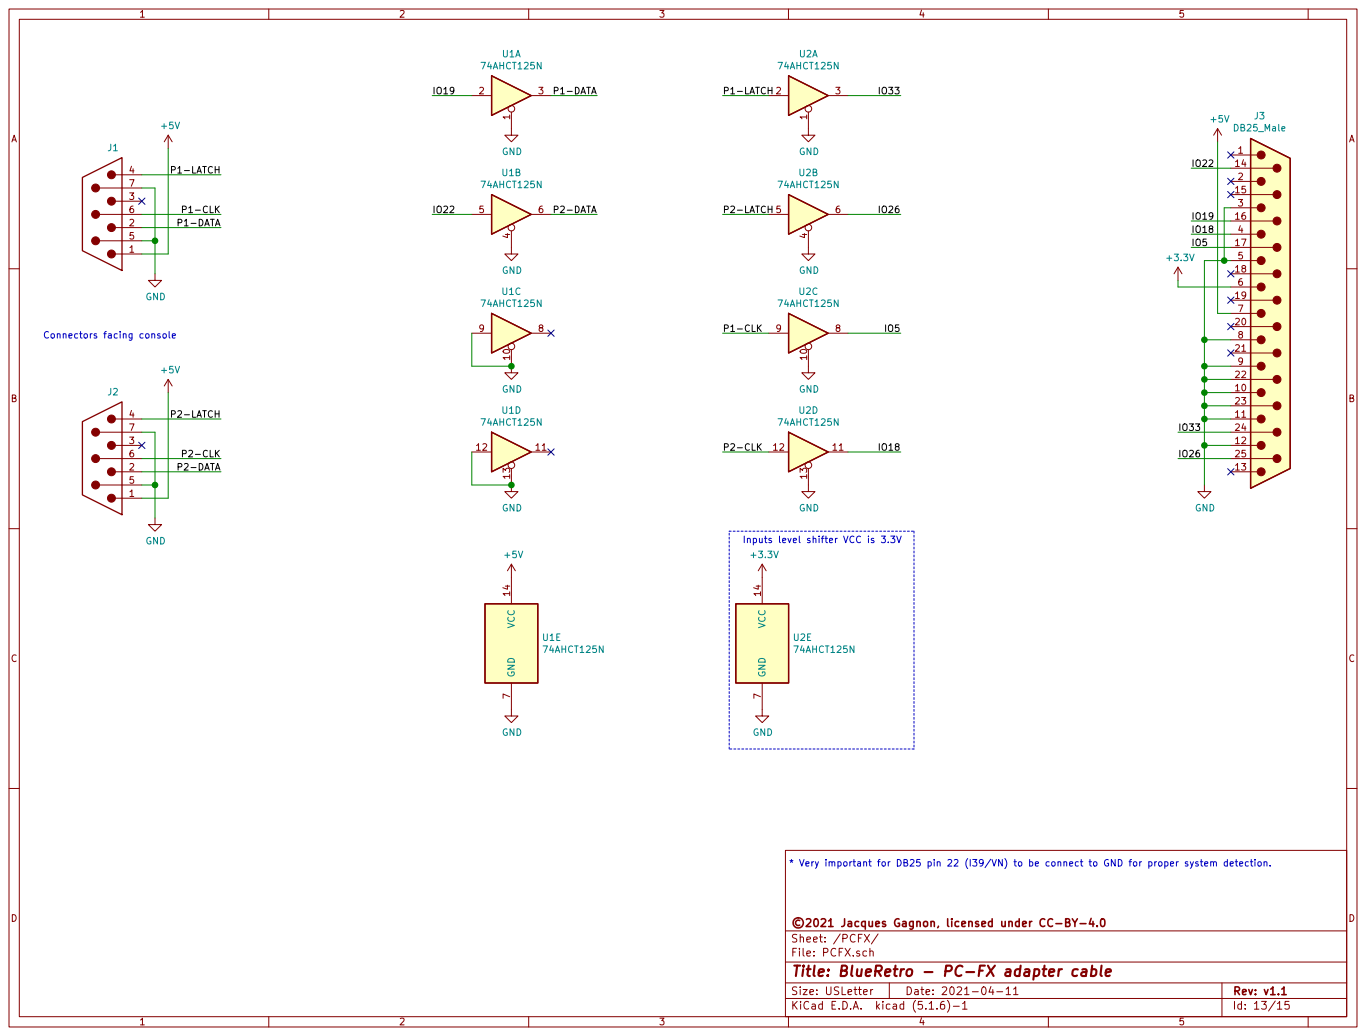
[picture p20: page 1]

Inputs level shifter VCC is 3.3V

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

Id: 13/15 Title: BlueRetro - PC-FX adapter cable
