darthcloud/BlueRetroHW/DIY/Dreamcast.pdf

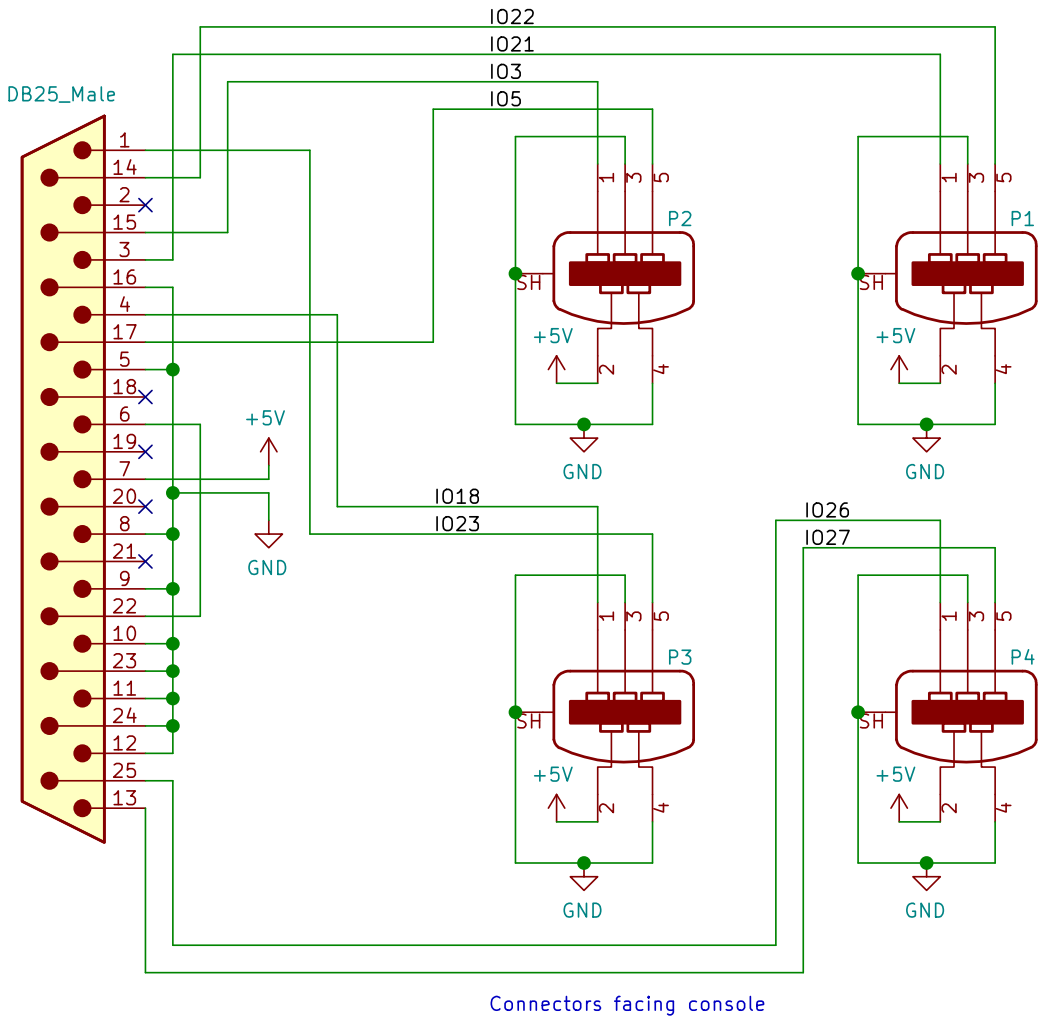
[picture p21: page 1]

File: Dreamcast.sch Sheet: /Dreamcast/ ©2020 Jacques Gagnon, licensed under CC-BY-4.0 GND

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

Id: 7/11 Title: BlueRetro - Dreamcast adapter cable
