darthcloud/BlueRetroHW/DIY/Genesis.pdf

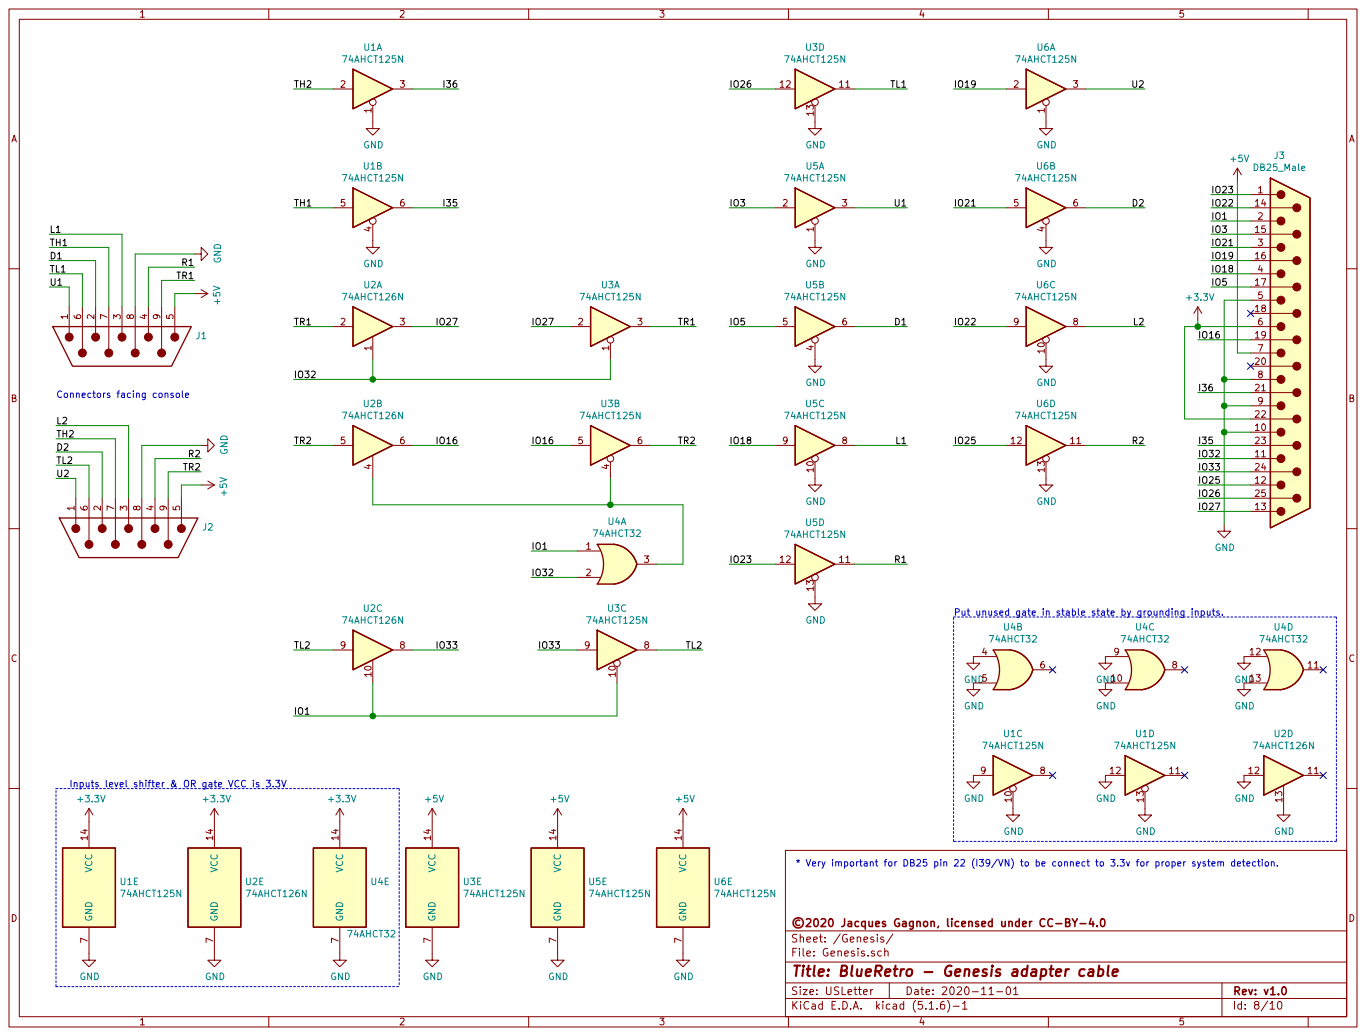
[picture p22: page 1]

Put unused gate in stable state by grounding inputs.

Inputs level shifter & OR gate VCC is 3.3V

File: Genesis.sch Sheet: /Genesis/ ©2020 Jacques Gagnon, licensed under CC-BY-4.0 VCC 14 GND

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

Id: 8/10 Title: BlueRetro - Genesis adapter cable
