darthcloud/BlueRetroHW/DIY/SNES.pdf

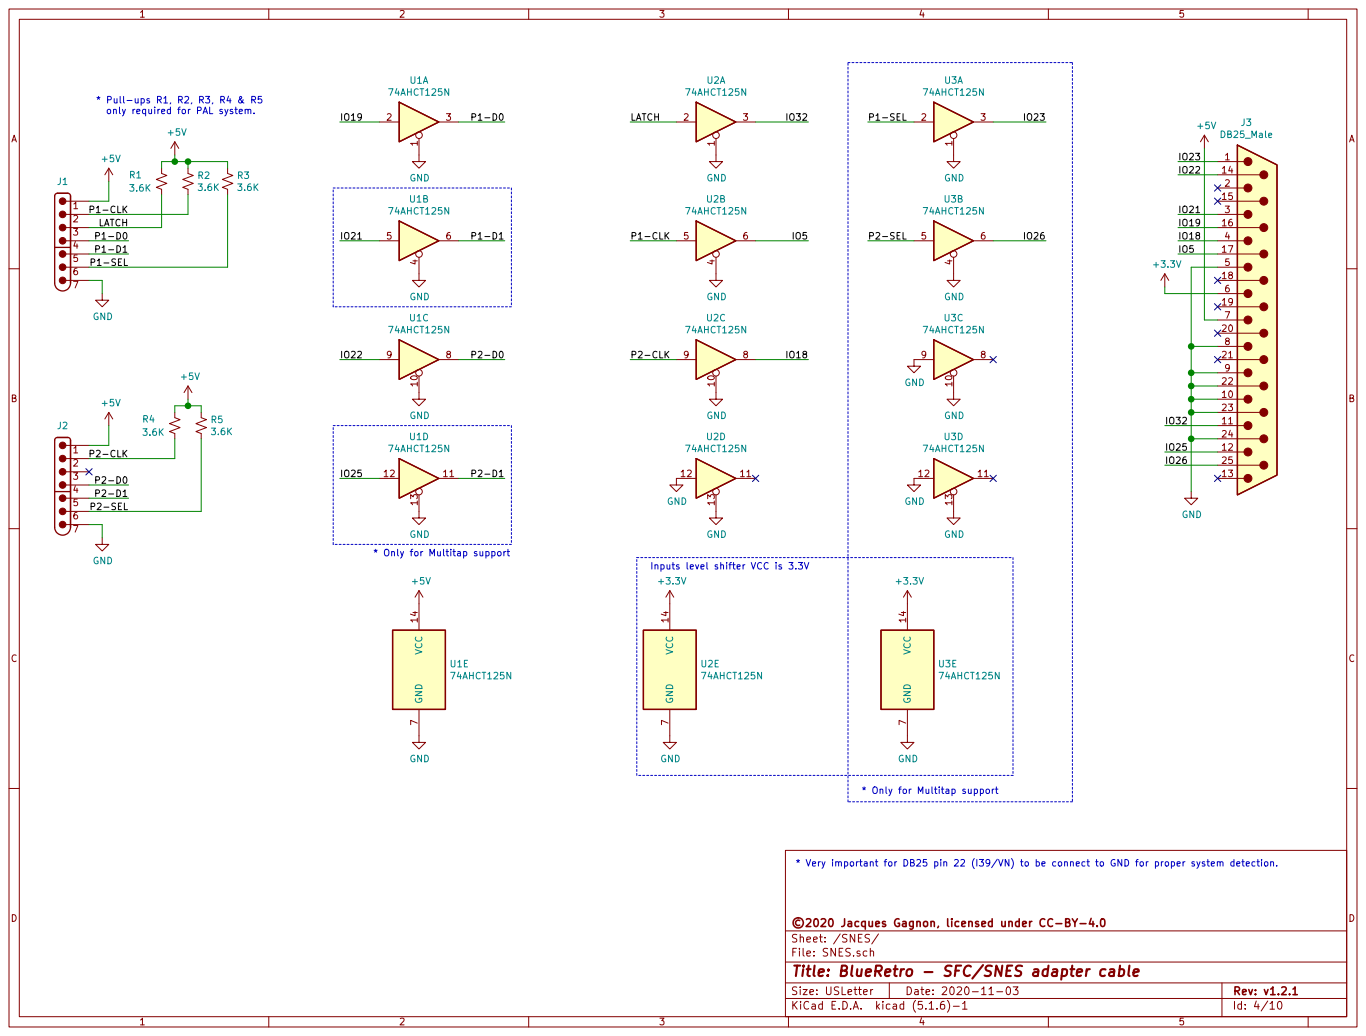
[picture p23: page 1]

* Pull-ups R1, R2, R3, R4 & R5
only required for PAL system.

File: SNES.sch Sheet: /SNES/ ©2020 Jacques Gagnon, licensed under CC-BY-4.0 GND

* Only for Multitap support

Inputs level shifter VCC is 3.3V

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

Id: 4/10 Title: BlueRetro - SFC/SNES adapter cable
