darthcloud/BlueRetroHW/DIY/GameCube.pdf

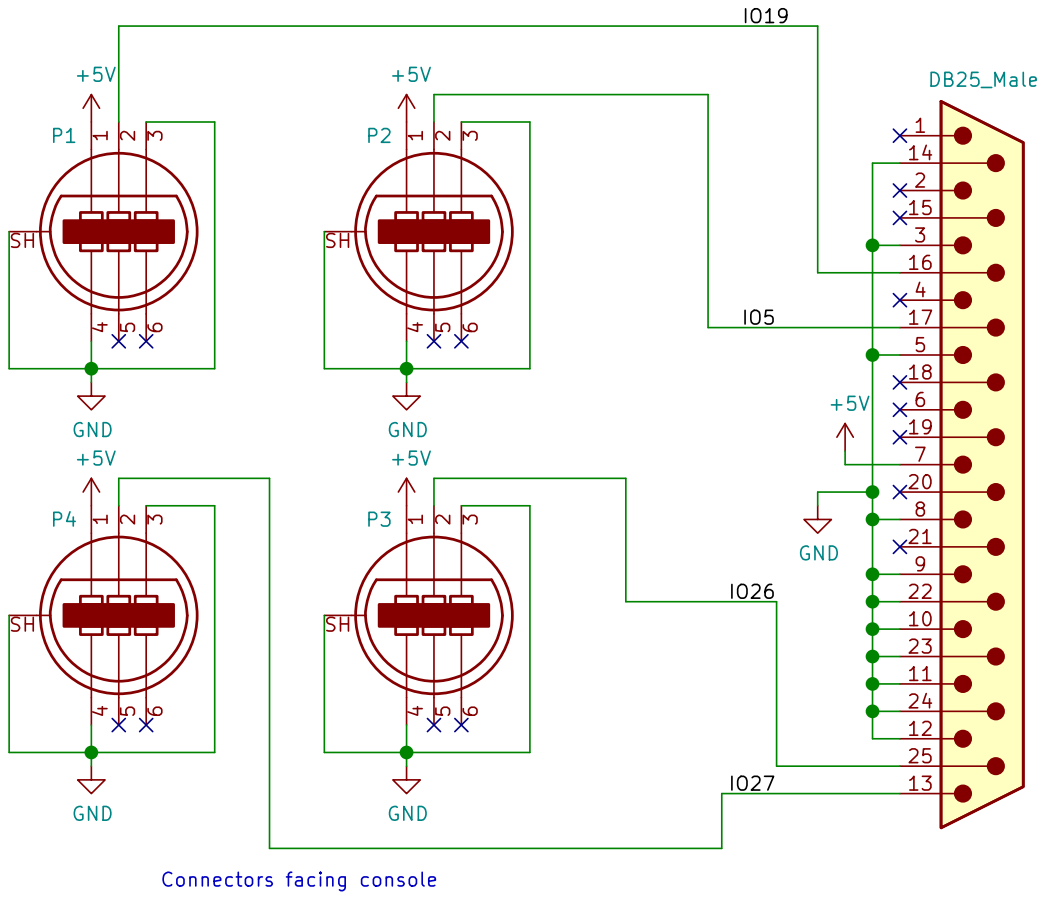
[picture p24: page 1]
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

File: GameCube.sch Sheet: /GameCube/ ©2020 Jacques Gagnon, licensed under CC-BY-4.0

Id: 6/7 Title: BlueRetro - GameCube adapter cable
