darthcloud/BlueRetroHW/Consolize/VirtualBoy/VirtualBoy.pdf

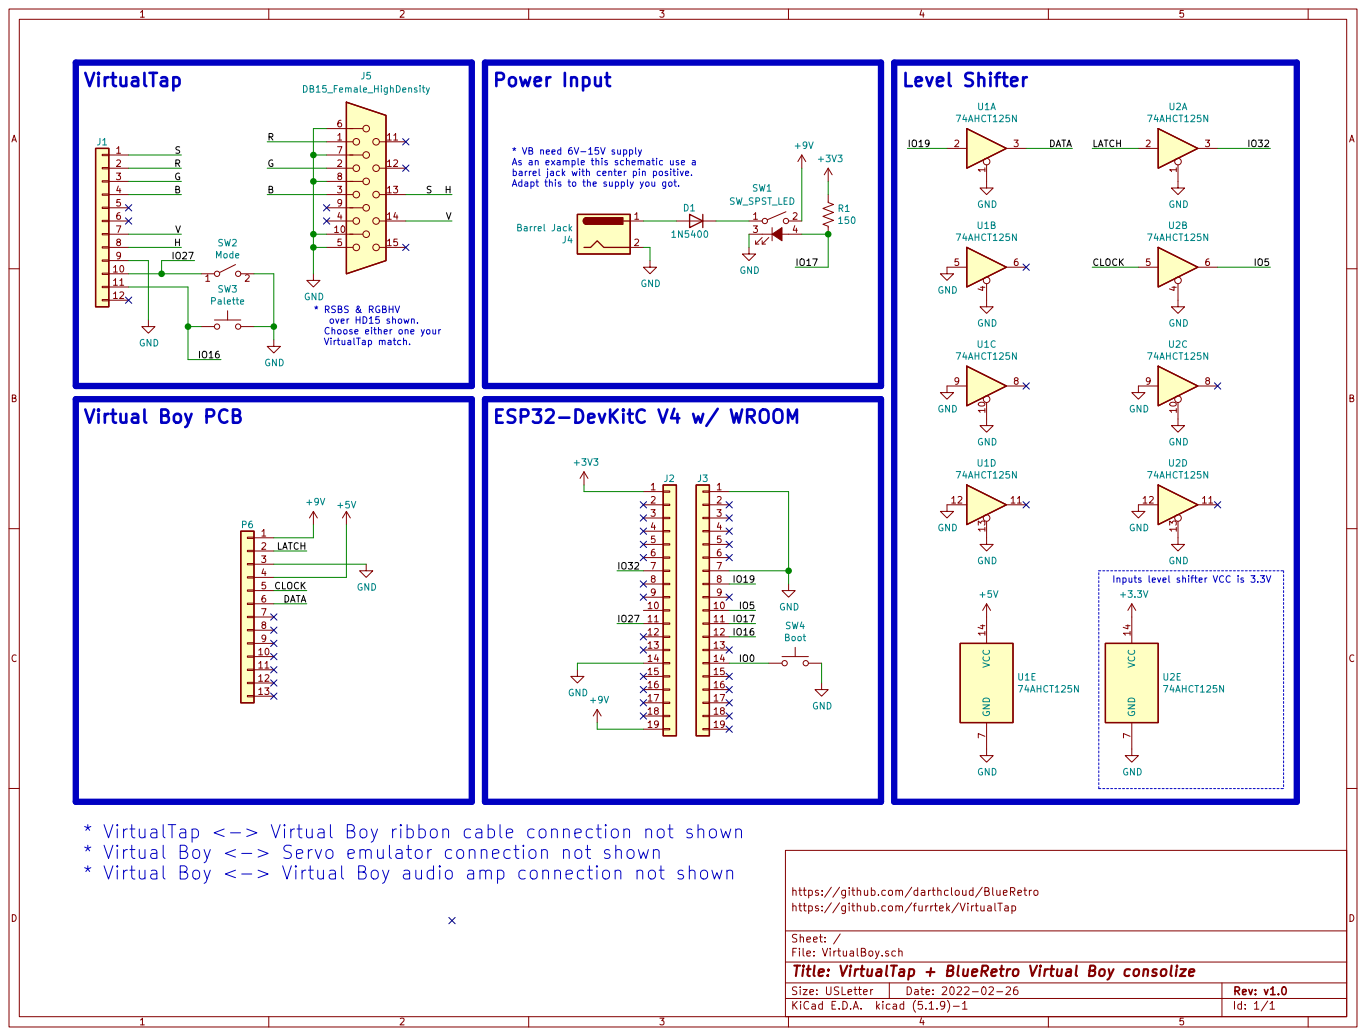
[picture p26: page 1]
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

* RSBS & RGBHV
over HD15 shown.
Choose either one your
VirtualTap match.

Inputs level shifter VCC is 3.3V

* VirtualTap <-> Virtual Boy ribbon cable connection not shown
* Virtual Boy <-> Servo emulator connection not shown
* Virtual Boy <-> Virtual Boy audio amp connection not shown

File: VirtualBoy.sch Sheet: / https://github.com/furrtek/VirtualTap

Id: 1/1 Title: VirtualTap + BlueRetro Virtual Boy consolize
