darthcloud/BlueRetroHW/Cables/jvs/jvs.pdf

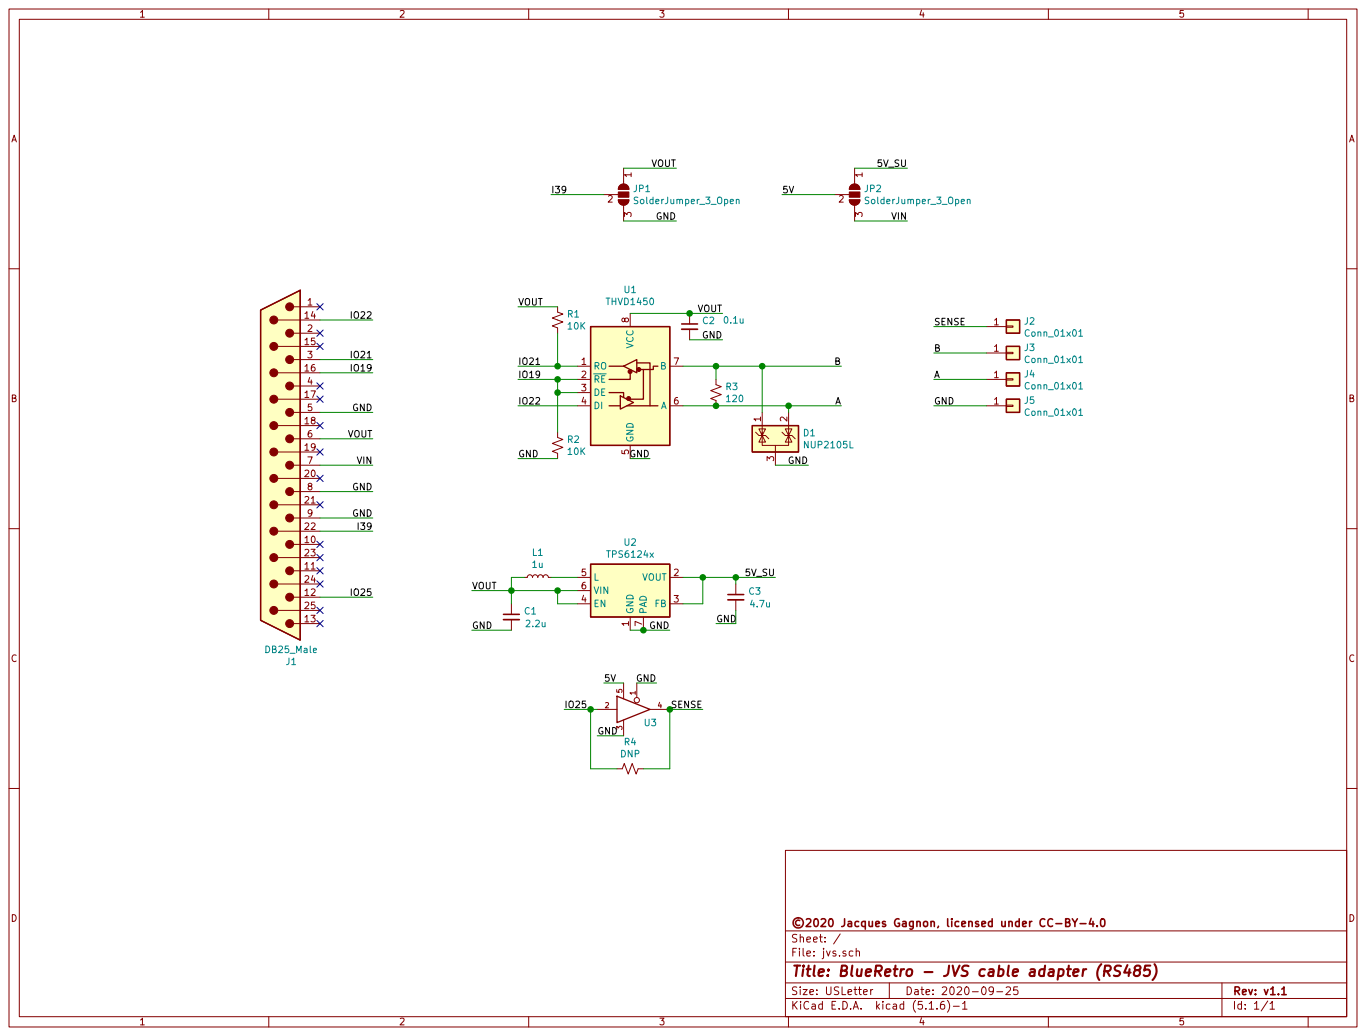
[picture p27: page 1]

7 U2 TPS6124x RO 1 RE 2 DE 3 DI 4 GND

File: jvs.sch Sheet: / ©2020 Jacques Gagnon, licensed under CC-BY-4.0 C3

Id: 1/1 Title: BlueRetro - JVS cable adapter (RS485)
