darthcloud/BlueRetroHW/Cables/passthrough/passthrough.pdf

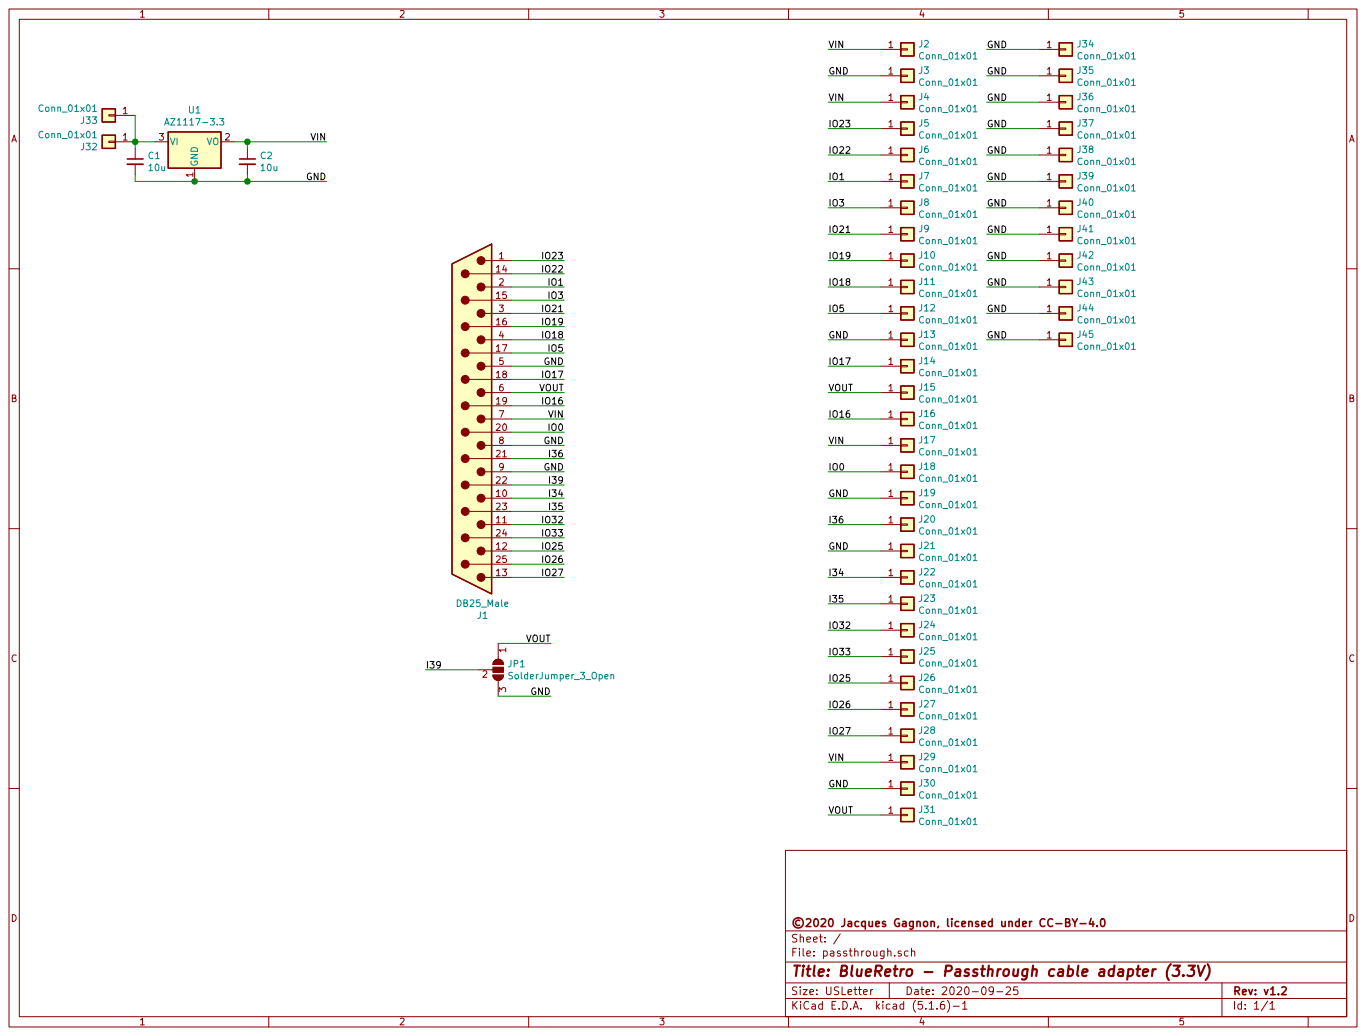
[picture p28: page 1]

Id: 1/1 Title: BlueRetro - Passthrough cable adapter (3.3V)
