darthcloud/BlueRetroHW/Testjig/LatencyTest.pdf

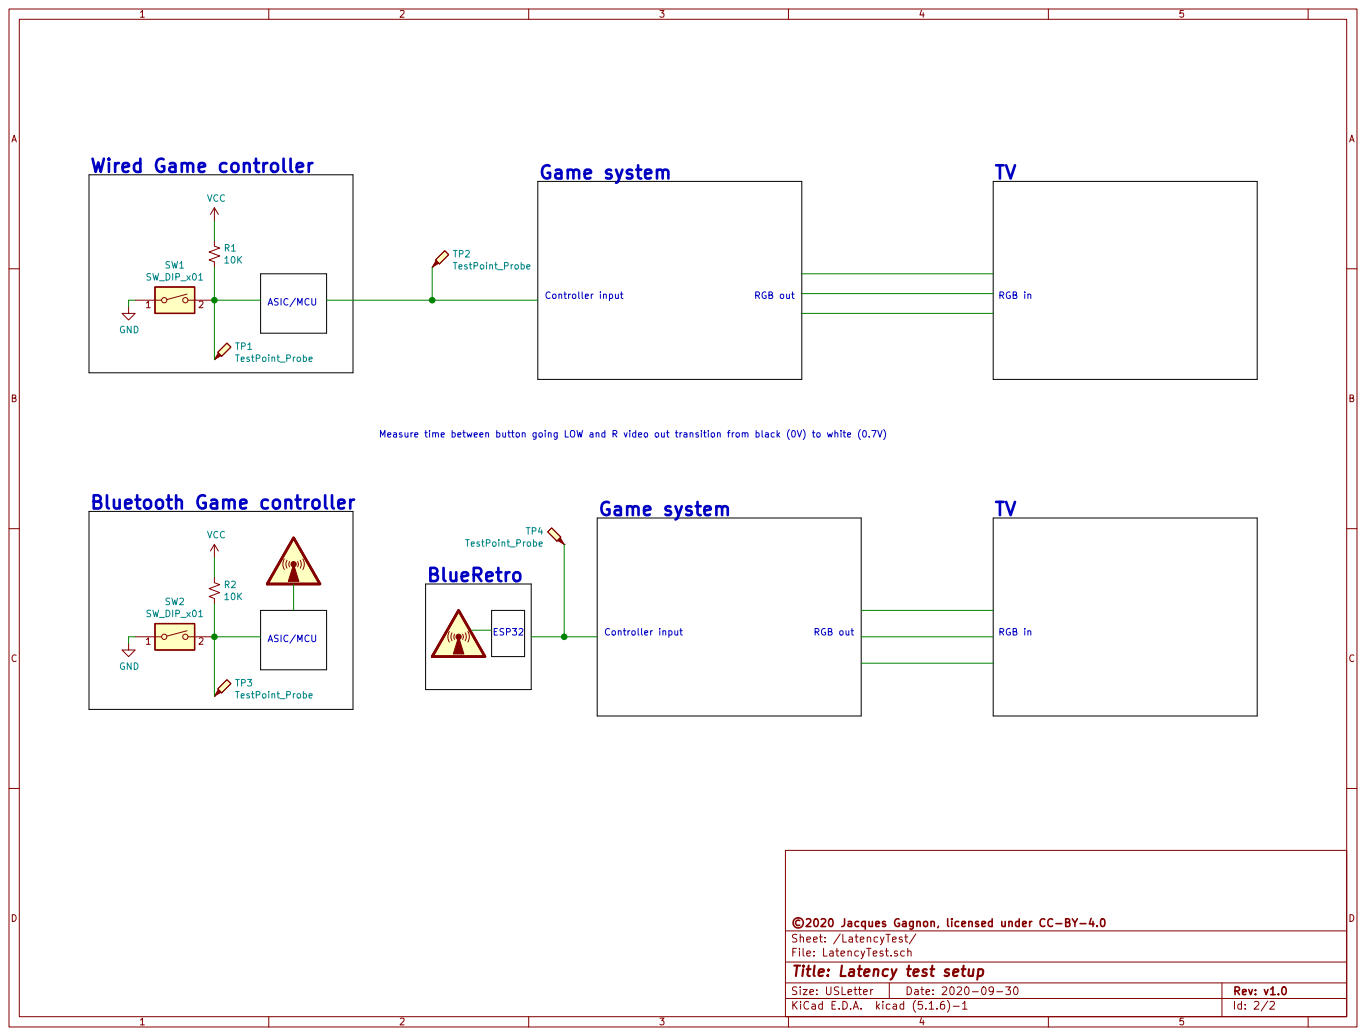
[picture p29: page 1]

©2020 Jacques Gagnon, licensed under CC-BY-4.0
Sheet: /LatencyTest/
File: LatencyTest.sch
Id: 2/2 Title: Latency test setup
