darthcloud/BlueRetroHW/DIY/BlueRetroDIY.pdf

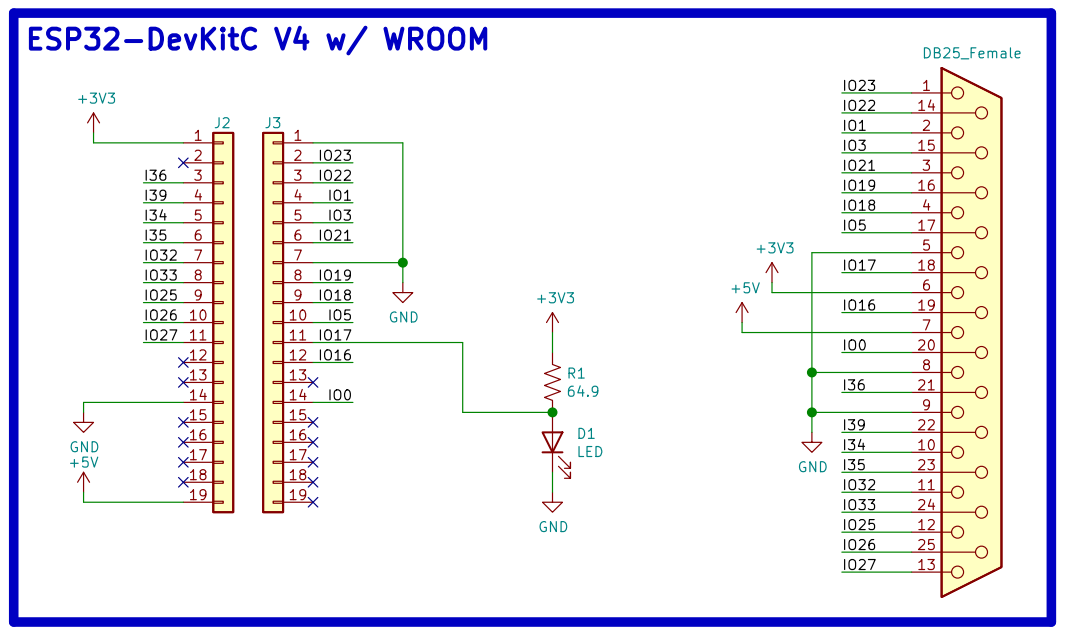
[picture p30: page 1]

File: BlueRetro.sch Sheet: / ©2020 Jacques Gagnon, licensed under CC-BY-4.0 Sheet: 3DO

Id: 1/16 Title: BlueRetro DIY
