darthcloud/BlueRetroHW/Cables/opendrain/opendrain.pdf

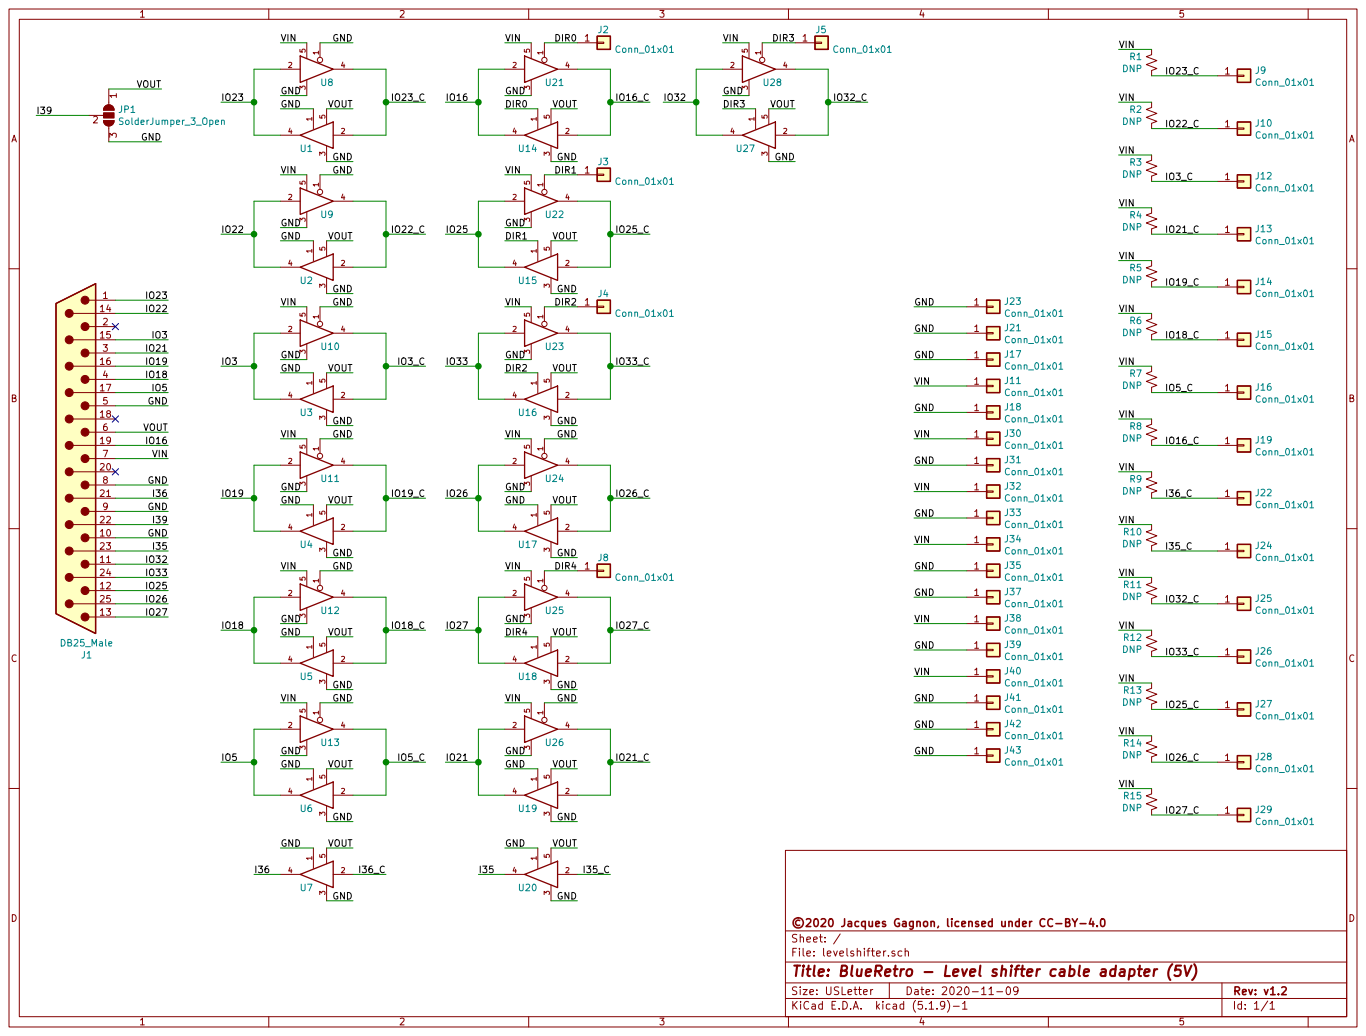
[picture p31: page 1]
