darthcloud/BlueRetroHW/(commit log)

2020-05-21 First version schematic
    [BlueRetro.kicad_pcb, BlueRetro.sch]
2020-07-19 Add SEGA Saturn adapter cable schematic
    [BlueRetro.sch, saturn.sch]
2020-07-26 Add NES schematic fixup Saturn detect pins
    [BlueRetro.sch, NES.sch, saturn.sch]
2020-07-29 Correction following first user feedback.
    [BlueRetro.sch]
2020-07-31 [DIY] Move DIY schematic in DIY directory
    [BlueRetro.kicad_pcb, BlueRetro.sch, NES.sch, saturn.sch]
2020-08-04 Add SNES adapter cable schematic
    [BlueRetro.sch, NES.sch, SNES.sch, saturn.sch]
2020-08-10 First draft DevKit schematic
    [BlueRetroCore.kicad_pcb, BlueRetroCore.sch]
2020-08-12 Basic placement PCB
    [BlueRetroCore.kicad_pcb, BlueRetroCore.sch]
2020-08-13 Add cutout for ESP32 antenna
    [BlueRetroCore.kicad_pcb]
2020-08-13 Footprint tweaks
    [BlueRetroCore.kicad_pcb]
2020-08-16 PCB routing
    [BlueRetroCore.kicad_pcb, BlueRetroCore.sch]
2020-08-16 Add logo
    [BlueRetroCore.kicad_pcb]
2020-08-17 Update schematic & BOM
    [BlueRetroCore.sch, BlueRetroCore_bom_v1.0.csv]
2020-08-19 Add 0.8mm pullback to board edge
    [BlueRetroCore.kicad_pcb]
2020-08-19 LED is on by default at boot and shutdown by software
    This allow to detect bootloader/flash issue
    [BlueRetroCore.kicad_pcb, BlueRetroCore.sch]
2020-08-22 [DIY] Update DIY & cable adapter schematic base on new DB25 mapping
    [BlueRetro.sch, Dreamcast.sch, GameCube.sch, N64.sch, NES.sch, SNES.sch, saturn.sch]
2020-08-22 Fix missing DB25 in BOM
    [BlueRetroCore.sch, BlueRetroCore_bom_v1.0.csv]
2020-08-22 [DevKit] Update schematic
2020-08-22 Rename output files
    [BlueRetroDevKit_bom_v1.0.csv]
2020-08-26 Replace D3 with a bigger alternative
    [BlueRetroCore.kicad_pcb, BlueRetroCore.sch, BlueRetroDevKit_bom_v1.0.csv]
2020-08-26 Fix SOT-223 Tab
    [BlueRetroCore.kicad_pcb, BlueRetroCore.sch]
2020-08-30 PCB revision v1.1
    [BlueRetroCore.kicad_pcb, BlueRetroCore.sch]
2020-08-30 Update schematic version
    [BlueRetroCore.sch, BlueRetroDevKit_bom.csv]
2020-08-31 Passthrough cable adapter PCB
    [passthrough.kicad_pcb, passthrough.sch]
2020-09-01 [PT] Add silkscreen info
    [passthrough.kicad_pcb]
2020-09-01 Add gerber folder to gitignore
2020-09-05 Initial version level shifter cable PCB
    [levelshifter.kicad_pcb, levelshifter.sch]
2020-09-06 Tweak PT & LS PCBs
    [levelshifter.kicad_pcb, passthrough.kicad_pcb]
2020-09-06 Add JVS RS485 cable adapter PCB
    [jvs.kicad_pcb, jvs.sch]
2020-09-06 Tweak for JVS PCB
    [jvs.kicad_pcb]
2020-09-06 Fix reversed DB25 on PT PCB
    [passthrough.kicad_pcb, passthrough.sch]
2020-09-07 Fixup inverted DB25 for Level Shifter PCB
    [levelshifter.kicad_pcb, levelshifter.sch]
2020-09-08 Final tweak for JVS & LS PCBs
    [jvs.kicad_pcb, levelshifter.kicad_pcb, levelshifter.sch]
2020-09-08 [DIY] Add note to cable schematics to underline how important I39 is.
    [Dreamcast.sch, GameCube.sch, N64.sch, NES.sch, SNES.sch, saturn.sch]
2020-09-25 Add LDO for PlayStation
    [passthrough.kicad_pcb, passthrough.sch]
2020-09-25 [JVS] Fixup Step Up feedback wiring
    [jvs.kicad_pcb, jvs.sch]
2020-10-03 Add testjig cable schematic
    [LatencyTest.sch, testjig.kicad_pcb, testjig.sch]
2020-10-03 Add console controller port symbol & reference
    [symbol.kicad_pcb, symbol.sch]
2020-10-03 Generate cable schematic PDF & add license info
    [jvs.sch, levelshifter.sch, passthrough.kicad_pcb, passthrough.sch]
2020-10-03 Use new port symbol in cable schematic
    [BlueRetro.sch, Dreamcast.sch, GameCube.sch, N64.sch, NES.sch, SNES.sch, saturn.sch]
2020-10-03 Document license in schematic
    [BlueRetroCore.sch]
2020-11-07 Update adapter cable schematics
    [BlueRetro.sch, Dreamcast.sch, GameCube.sch, Genesis.sch, N64.sch, NES.sch, NeoGeo.sch, SMS.sch]
2020-11-09 [LS] Rework GND and VOUT supplies
    [levelshifter.kicad_pcb]
2020-11-09 [LS] Add pull-up footprint on 5V side for PAL NES & SNES cables
    [levelshifter.kicad_pcb, levelshifter.sch]
2020-11-29 Add PlayStation 1/2 adapter cable
    [BlueRetro.sch, Dreamcast.sch, GameCube.sch, Genesis.sch, N64.sch, NES.sch, NeoGeo.sch, PS.sch]
2021-02-05 Fixup Dreamcast DIY schematic mirrored ports
    Thanks Vuk Vukašinović for reporting!
    [Dreamcast.sch]
2021-03-02 [DIY] Update playstation cable
    [PS.sch]
2021-03-18 [DIY] Add 7800 2 btns adapter
    [SMS.sch]
2021-03-27 Add 3DO cable adapter
    [3DO.sch, BlueRetro.sch]
2021-04-02 Update NEC pinouts
    [symbol.sch]
2021-04-02 [DIY] Add PC-FX adapter cable
    [3DO.sch, BlueRetro.sch, Dreamcast.sch, GameCube.sch, Genesis.sch, N64.sch, NES.sch, NeoGeo.sch]
2021-04-12 [DIY] Fixup PC-FX DB25 pin3 and add CD-i cable adapter
    [3DO.sch, BlueRetro.sch, CDI.sch, Dreamcast.sch, GameCube.sch, Genesis.sch, N64.sch, NES.sch]
2021-04-27 [DIY] Add PCE/TG16 adapter cable
    [3DO.sch, BlueRetro.sch, CDI.sch, Dreamcast.sch, GameCube.sch, Genesis.sch, N64.sch, NES.sch]
2021-06-05 [DIY] Add Jaguar adapter cable
    [3DO.sch, BlueRetro.sch, CDI.sch, Dreamcast.sch, GameCube.sch, Genesis.sch, JAG.sch, N64.sch]
2021-12-09 [DIY] Remove sd card and add status LED
    [BlueRetro.sch]
2022-01-11 [Cables] Add Virtual Boy connector symbol
    [symbol.sch]
2022-01-11 [DIY] Add Virtual Boy adapter cable
    [3DO.sch, BlueRetro.sch, CDI.sch, Dreamcast.sch, GameCube.sch, Genesis.sch, JAG.sch, N64.sch]
2022-01-18 [Cables] Update ls pcb pdf
2022-01-31 [DIY] Add open drain variant for parallel cables
    [3DO.sch, BlueRetro.sch, CDI.sch, Dreamcast.sch, GameCube.sch, Genesis.sch, JAG.sch, N64.sch]
2022-02-01 Add open drain cable pcb
    [opendrain.kicad_pcb, opendrain.sch]
2022-02-05 Simplify parallel schematics
    [3DO.sch, 7800.sch, BlueRetro.sch, CDI.sch, Dreamcast.sch, GameCube.sch, Genesis.sch, JAG.sch]
2022-02-14 Fixup PCE schematic inversion of /OE and SEL line
    [PCE.sch]
2022-02-26 Add Virtual Boy consolize schem
    [VirtualBoy.kicad_pcb, VirtualBoy.sch]
2022-02-26 Change VB schem to use barrel center pin positive
    [VB.sch]
2022-02-26 Add servo note for VB consolize
    [VirtualBoy.sch]
2022-03-15 [DIY] Fixup N64 & PSX schematic
    [N64.sch, PS.sch]
2022-05-22 Add Wii-ext schematic
    [3DO.sch, 7800.sch, BlueRetro.sch, CDI.sch, Dreamcast.sch, GameCube.sch, Genesis.sch, JAG.sch]
2023-04-10 Simplify BR devkit
    [BlueRetroCore.kicad_pcb, BlueRetroCore.sch]
2023-11-22 Update PS schematic base on latest info found to avoid random input
    [PS.sch]
2023-11-23 Split NES and FC schematic into 3 types
    [3DO.sch, 7800.sch, AVFC.sch, BlueRetro.sch, CDI.sch, Dreamcast.sch, FC.sch, GameCube.sch]
2023-11-29 Add diode on PS power input, help with random input aswell
    [PS.sch]
2024-04-14 Add pullup to OD outputs on ESP side
    [AVFC.sch, FC.sch, NES.sch, Para1P_OD.sch, Para2P_OD.sch]
